Pai-88/cadence-fog-monitor/deliverables/cadence_leaflet_fog.pptx

UCL ENGF0031 · SMART CLOTHING PROTOTYPE

Cadence

A wearable that catches a Parkinson's gait freeze and shows it the instant it happens — on the body, on screen.

ONE SENSOR. THREE JOBS.

MONITOR

Tracks walking activity and movement energy continuously from one ankle accelerometer.

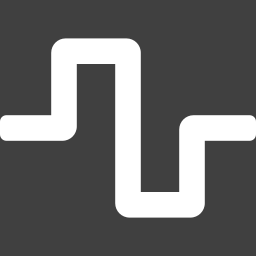
[picture p7: figure]

DETECT

Spots freezing of gait with a model trained and validated on real patient recordings.

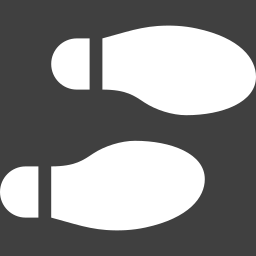
[picture p8: figure]

DISPLAY

Shows the live freeze state on an on-body OLED and logs every episode for the clinic.


HOW IT WORKS — FROM ANKLE TO SCREEN

Each freeze shows on-screen the instant it is detected, and is logged for review — one sensor in, one clear answer out.

SENSE
64 Hz · ankle

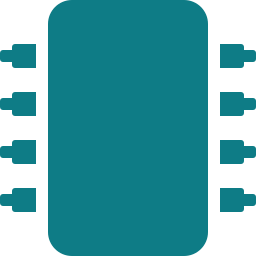
[picture p10: figure]

DETECT
freeze? (model)

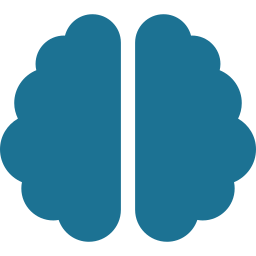
[picture p11: figure]

DISPLAY
OLED + log

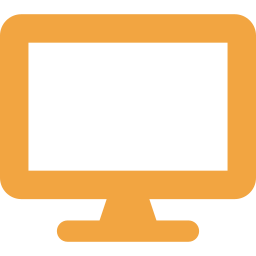
[picture p12: figure]
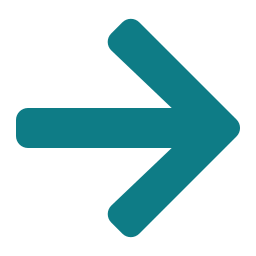
[picture p13: figure]

≈50%

of people with Parkinson's
experience freezing of gait*

64 Hz

single ankle
accelerometer

~2 s

freeze re-checked,
shown on the body

*Estimates vary with disease stage and assessment; commonly cited around 50%.

In good company. Builds on ideas demonstrated by Apple Watch's Movement Disorder API, PDMonitor and STAT-ON — clinical-grade Parkinson's monitors — in one low-cost wearable.

Validated on real patient recordings (Daphnet) using leave-one-subject-out testing.

Research prototype — not a medical device
UCL ENGF0031 Scenario 2 · 2026

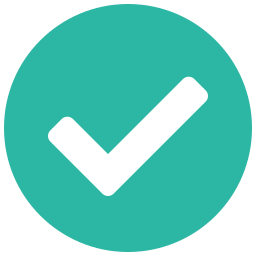
[picture p14: figure]

Cadence — wearable freeze-of-gait monitor
