Pai-88/cadence-fog-monitor/hardware/sleeve_layout.pdf

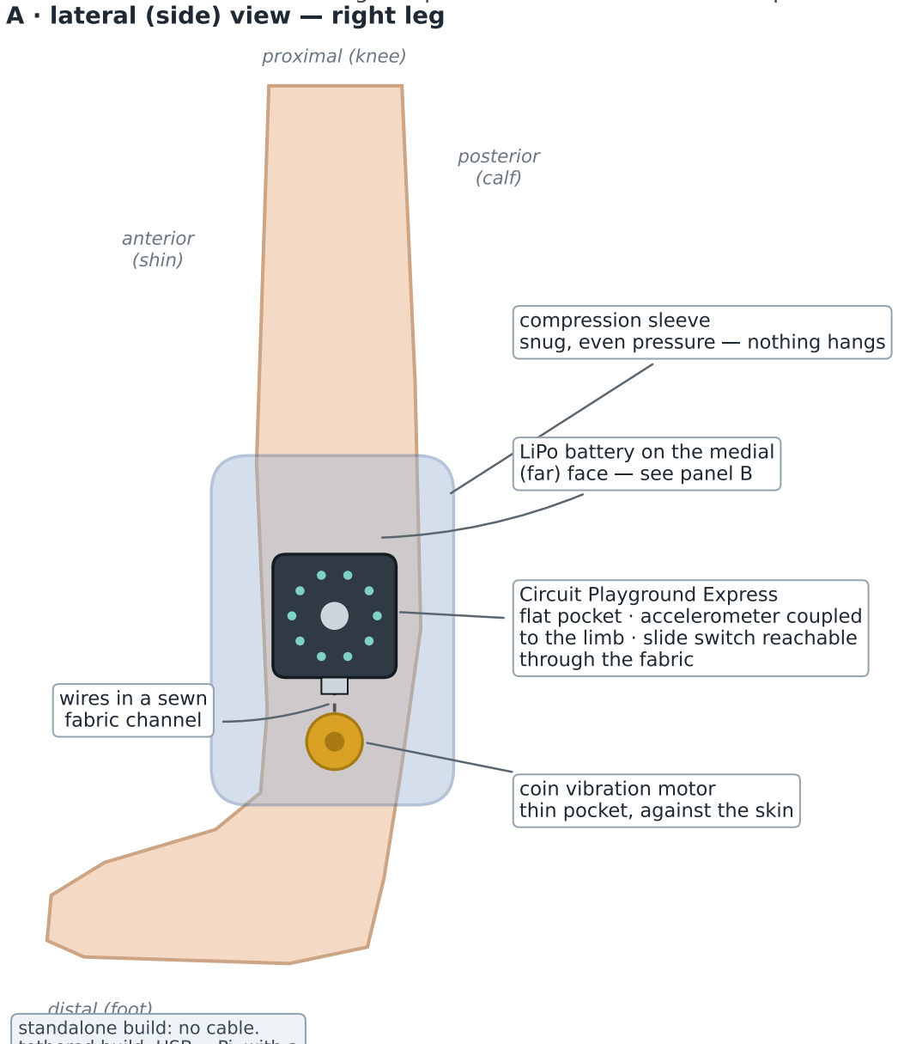
[picture p15: figure]
proximal (knee); distal (foot); anterior (shin); posterior (calf); standalone build: no cable.; A · lateral (side) view; right leg; compression sleeve snug, even pressure nothing hangs; LiPo battery on the medial (far) face see panel B; Circuit Playground Express flat pocket · accelerometer coupled to the limb · slide switch reachable through the fabric; coin vibration motor thin pocket, against the skin; wires in a sewn fabric channel

tethered build: USB Pi, with a strain-relief service loop.

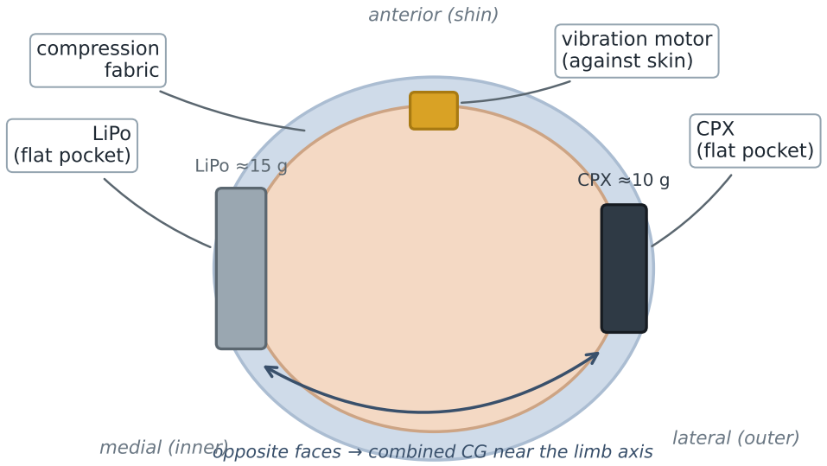
[picture p16: figure]
CPX 10 g; LiPo 15 g; anterior (shin); lateral (outer) medial (inner); CPX (flat pocket); LiPo (flat pocket); vibration motor (against skin) compression fabric

opposite faces combined CG near the limb axis

posterior (calf)

B · cross-section (looking toward the foot)

limb /
skin

inner fabric

component
(CPX / LiPo)

outer fabric
(closes pocket)

toward limb outside

3 4 mm sits flush, nothing to snag

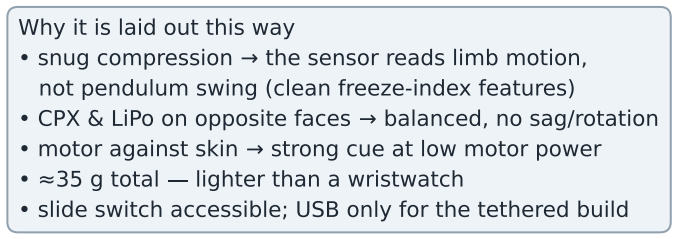
[picture p17: figure]
Why it is laid out this way; 35 g total lighter than a wristwatch

snug compression the sensor reads limb motion,
not pendulum swing (clean freeze-index features)
CPX & LiPo on opposite faces balanced, no sag/rotation motor against skin strong cue at low motor power

slide switch accessible; USB only for the tethered build

C · flat-pocket layer stack (radial section)

Parkinson's gait garment ankle-sleeve component layout snug compression sleeve · flat internal pockets · nothing hangs · 35 g total (CPX 10 g + LiPo 15 g + motor 2 g)
