Pai-88/cadence-fog-monitor/worksheet/demo_how_it_decides.pdf

# How the wrist band decides: REST · MOVE · TREMOR

No maths needed to run the demo — the band just checks two things every 2 seconds, then lights up one of three states.

Do this first (set-up): Hold your wrist still and press button A. The band learns your normal resting hand, so the “line” it compares against is personal to you. (Until you do, the ring glows dim white = “not calibrated yet”.)

Every 2 seconds, it measures two things about your wrist:

### 1. Arm movement

Big, slow motion — reaching, waving, walking. “Are you using your hand on purpose?”

### 2. Tremor shake

A fast, fine, rhythmic shake while the hand is otherwise still — the Parkinson’s resting tremor.

Then it picks one of three — checked in this order:

### 1 MOVE

Arm is moving about.
You’re doing something on purpose. A resting tremor only shows at rest, so the band stays quiet — no false alarms on normal activity.

You’ll see: dim teal ring · screen says moving

### 2 TREMOR

Still, but shaking past your line.
Hand at rest and trembling more than your calibrated normal — so it flags a tremor. Stronger shake → more lights fill the ring.

You’ll see: amber bar (length = strength) · screen says TREMOR present

### 3 REST

Still and calm.
No big movement, no tremor shake — nothing going on. All clear. The default whenever the other two aren’t true.

You’ll see: soft green ring · screen says no tremor

Show it in three moves: 1. Hold still → REST (green). 2. Wave your hand around → MOVE (teal). 3. Rest your hand and shake it fast → TREMOR (amber).

If someone asks “how does it know?” — the one-line answer: “It measures how strongly the hand shakes at a tremor’s rhythm, and whether you’re otherwise still.” (Under the hood that’s the strength of 4–6 Hz shaking, and it waits for two readings in a row before switching — but you don’t need to say any of that to run the demo.)

1
