Pai-88/cadence-fog-monitor/colab/fog_plots/interp_partial_dependence.png

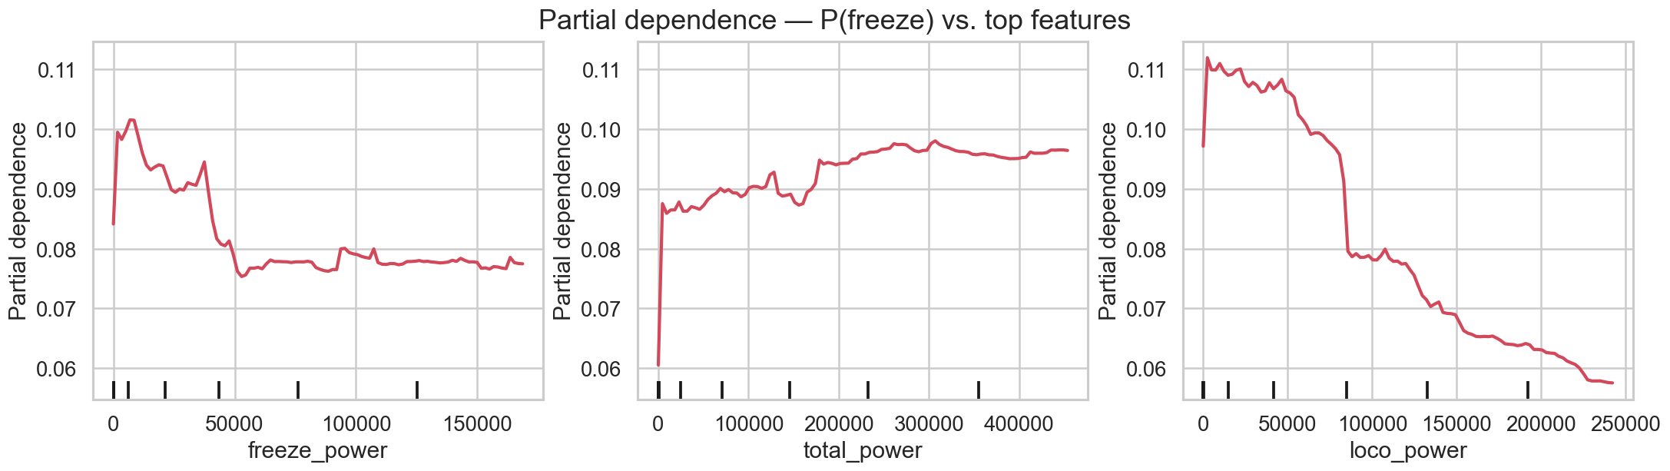
colab/fog_plots/interp_partial_dependence.png
