Pai-88/cadence-fog-monitor/colab/fog_plots/interp_perm_importance.png

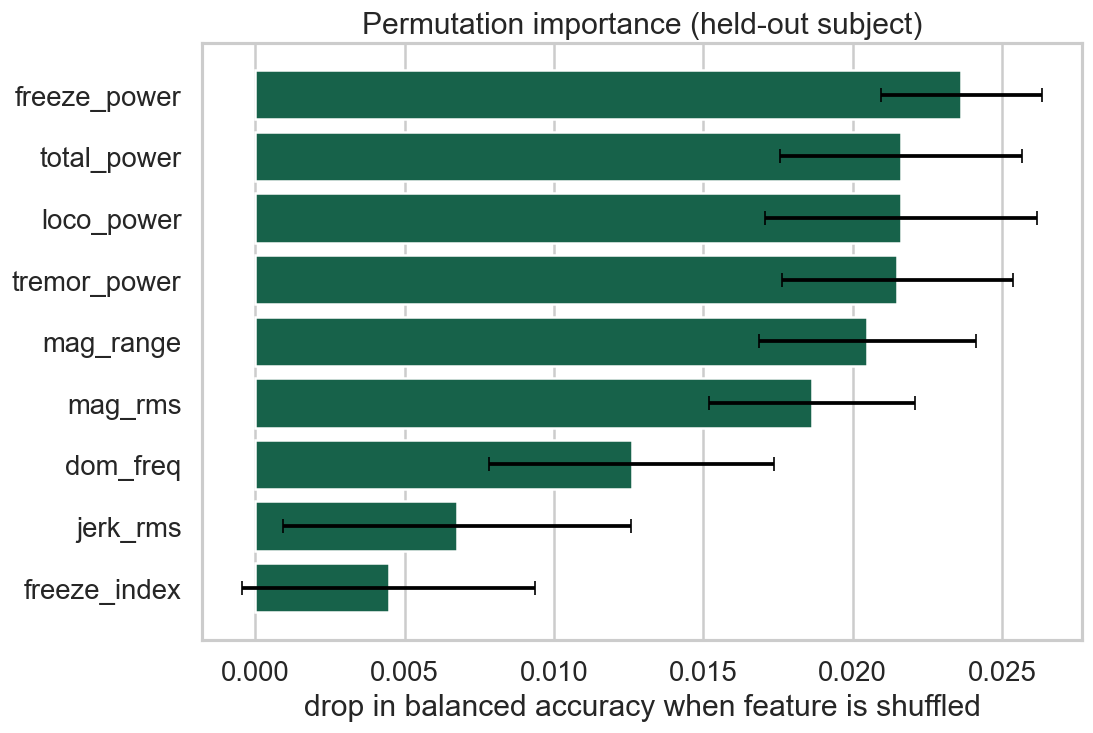
colab/fog_plots/interp_perm_importance.png
