Pai-88/cadence-fog-monitor/colab/fog_plots/interp_shap_bar.png

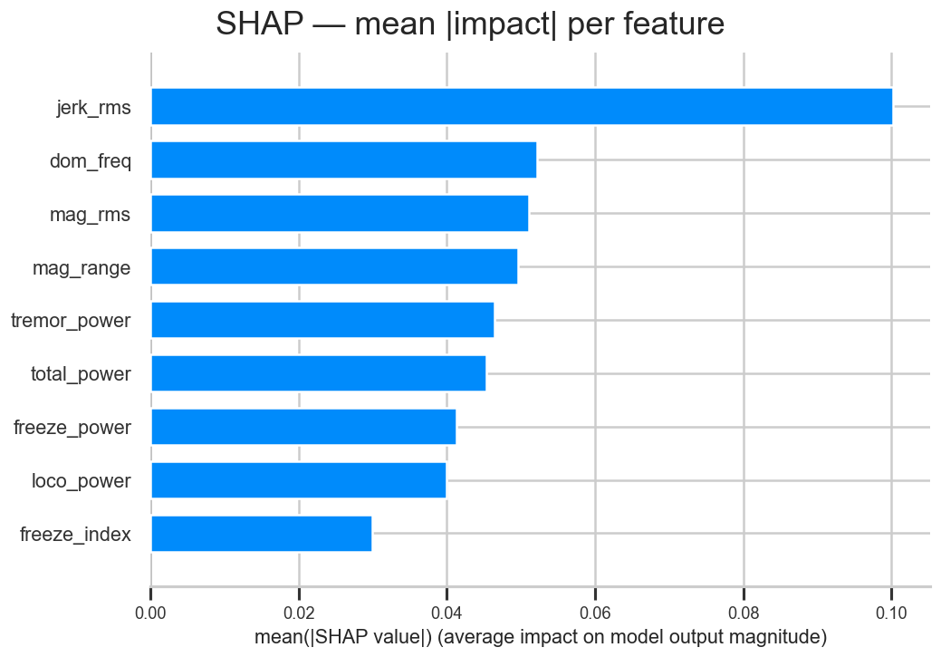
colab/fog_plots/interp_shap_bar.png
