Pai-88/cadence-fog-monitor/colab/fog_plots/interp_shap_beeswarm.png

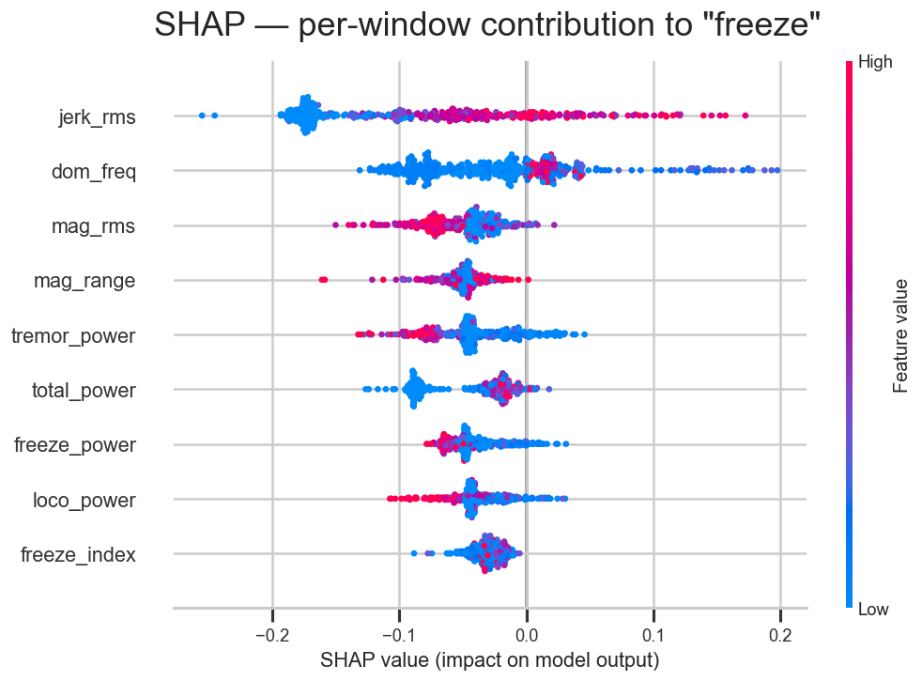
colab/fog_plots/interp_shap_beeswarm.png
