Pai-88/cadence-fog-monitor/deliverables/fogqa2-1.jpg

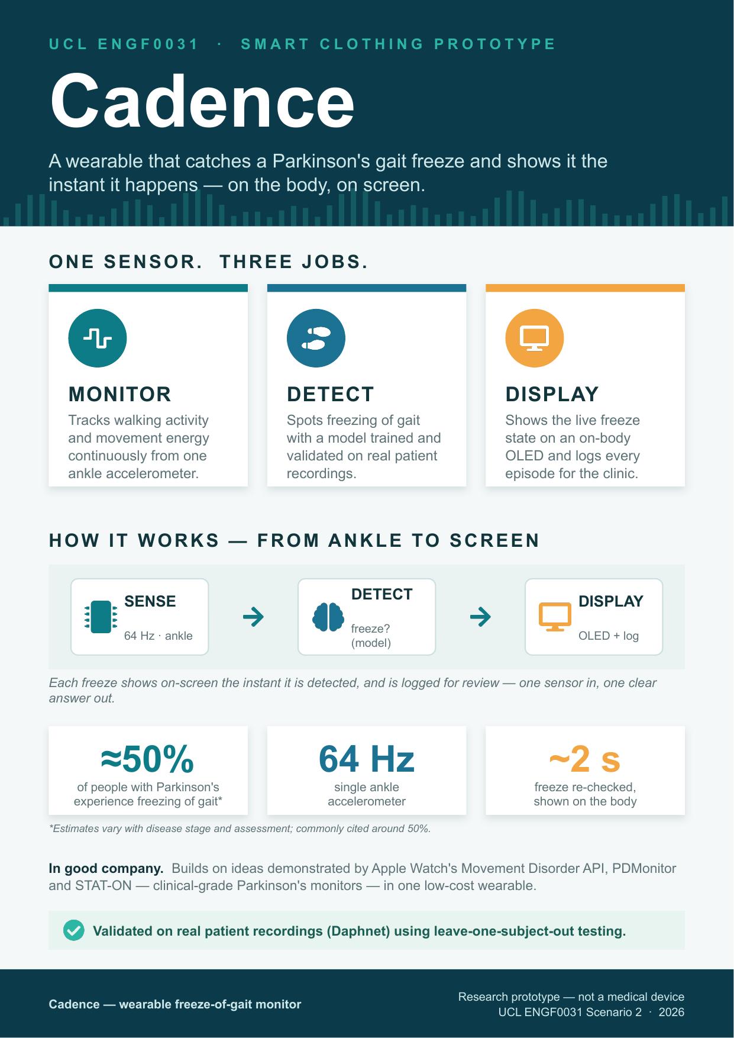
deliverables/fogqa2-1.jpg
