Pai-88/cadence-fog-monitor/hardware/coding_flowchart.png

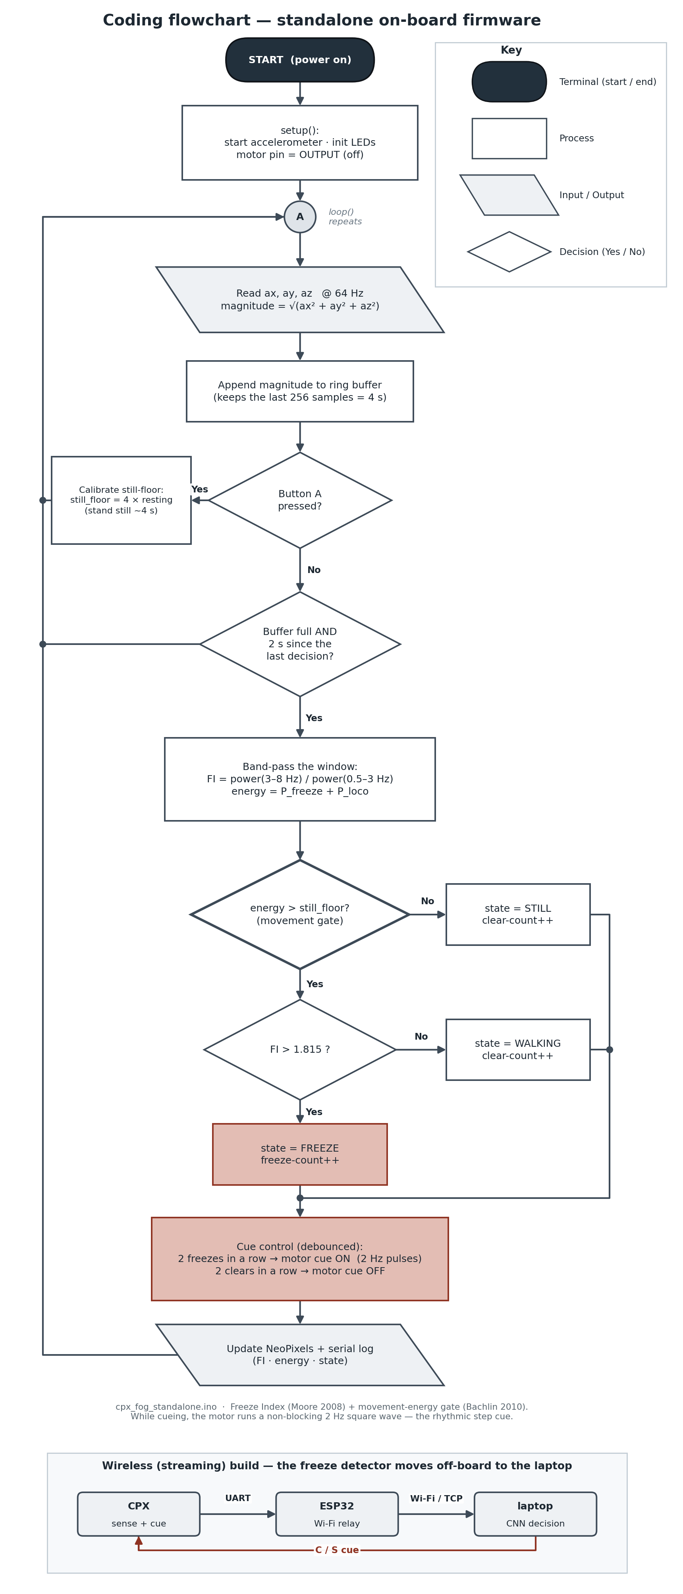
hardware/coding_flowchart.png
