Pai-88/cadence-fog-monitor/hardware/sleeve_layout.png

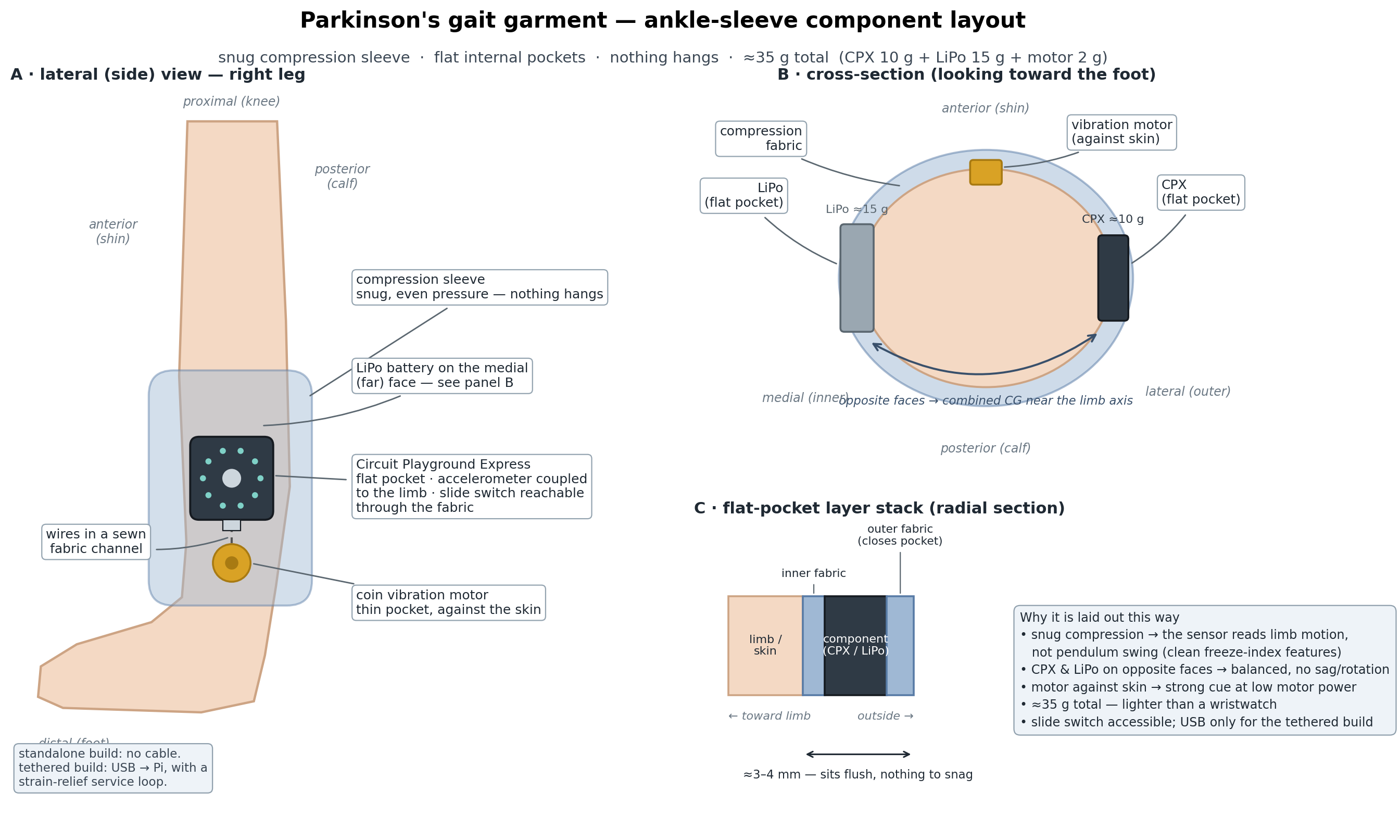
hardware/sleeve_layout.png
