Pai-88/cadence-fog-monitor/hardware/wp1_right.png

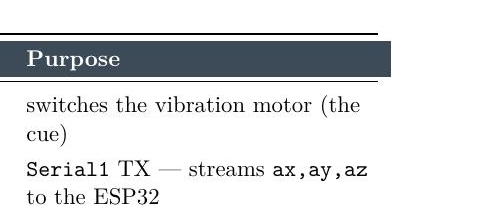
hardware/wp1_right.png
