Pai-88/cadence-fog-monitor/hardware/wp2_right2.png

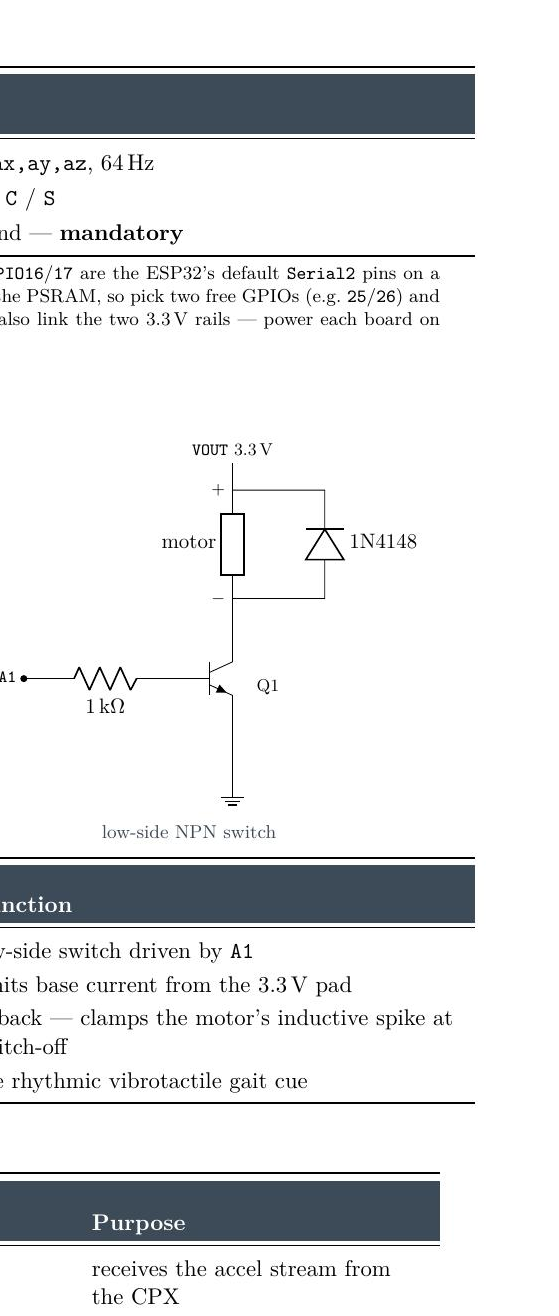
hardware/wp2_right2.png
