Pai-88/cadence-fog-monitor/hardware/wp2_right.png

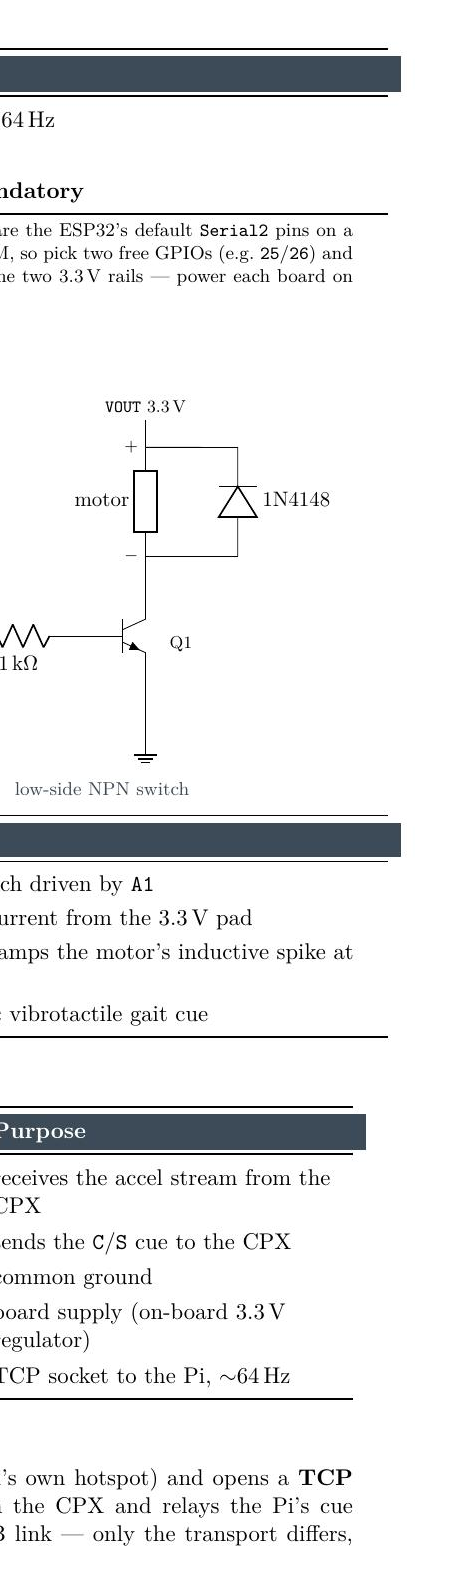
hardware/wp2_right.png
