Pai-88/cadence-fog-monitor/hardware/wp3_host.png

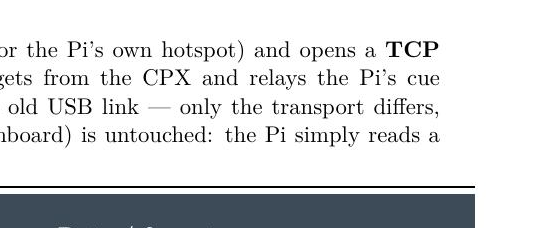
hardware/wp3_host.png
