Pai-88/cadence-fog-monitor/hardware/wp3_right.png

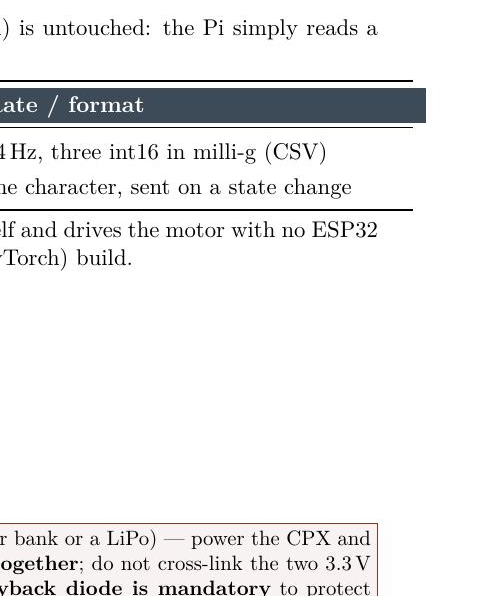
hardware/wp3_right.png
