Pai-88/cadence-fog-monitor/hardware/wp-1.jpg

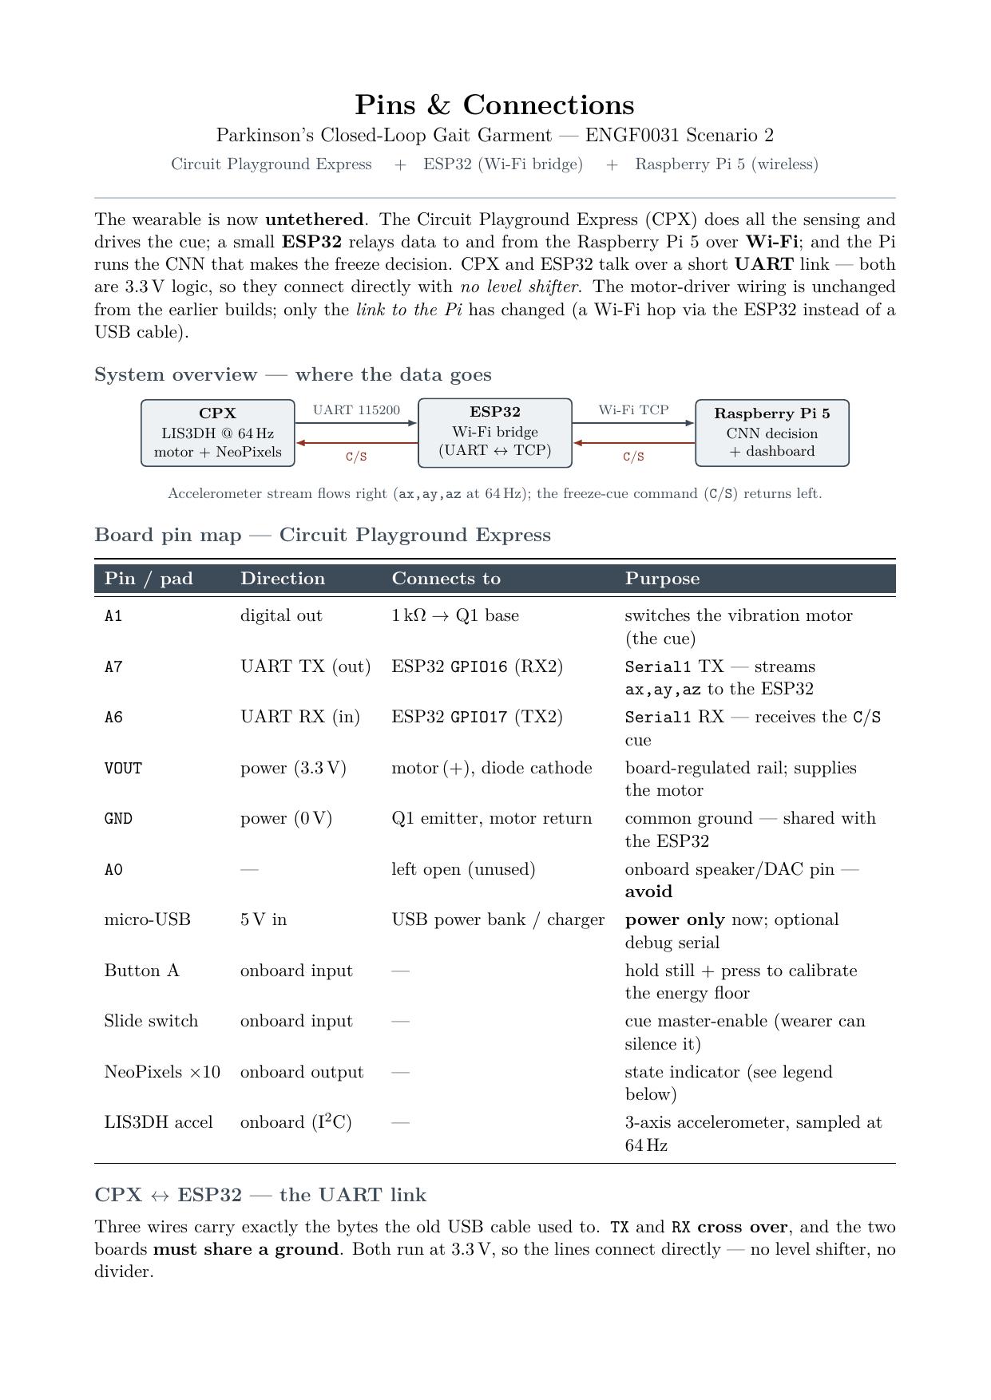
hardware/wp-1.jpg
