Pai-88/cadence-fog-monitor/hardware/wp-2.jpg

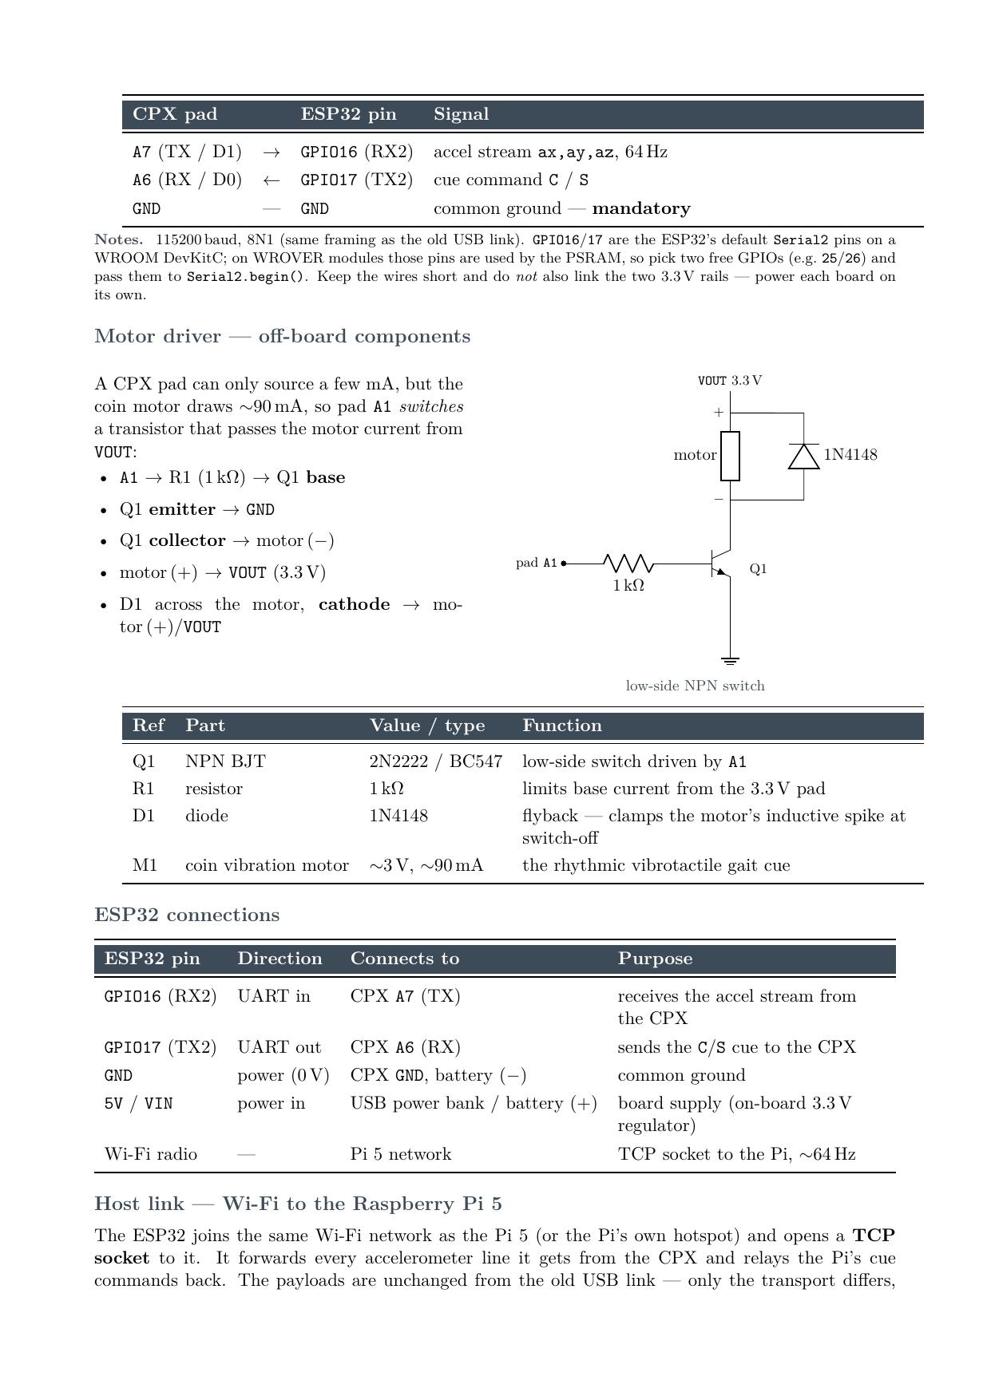
hardware/wp-2.jpg
