Pai-88/cadence-fog-monitor/hardware/wp-3.jpg

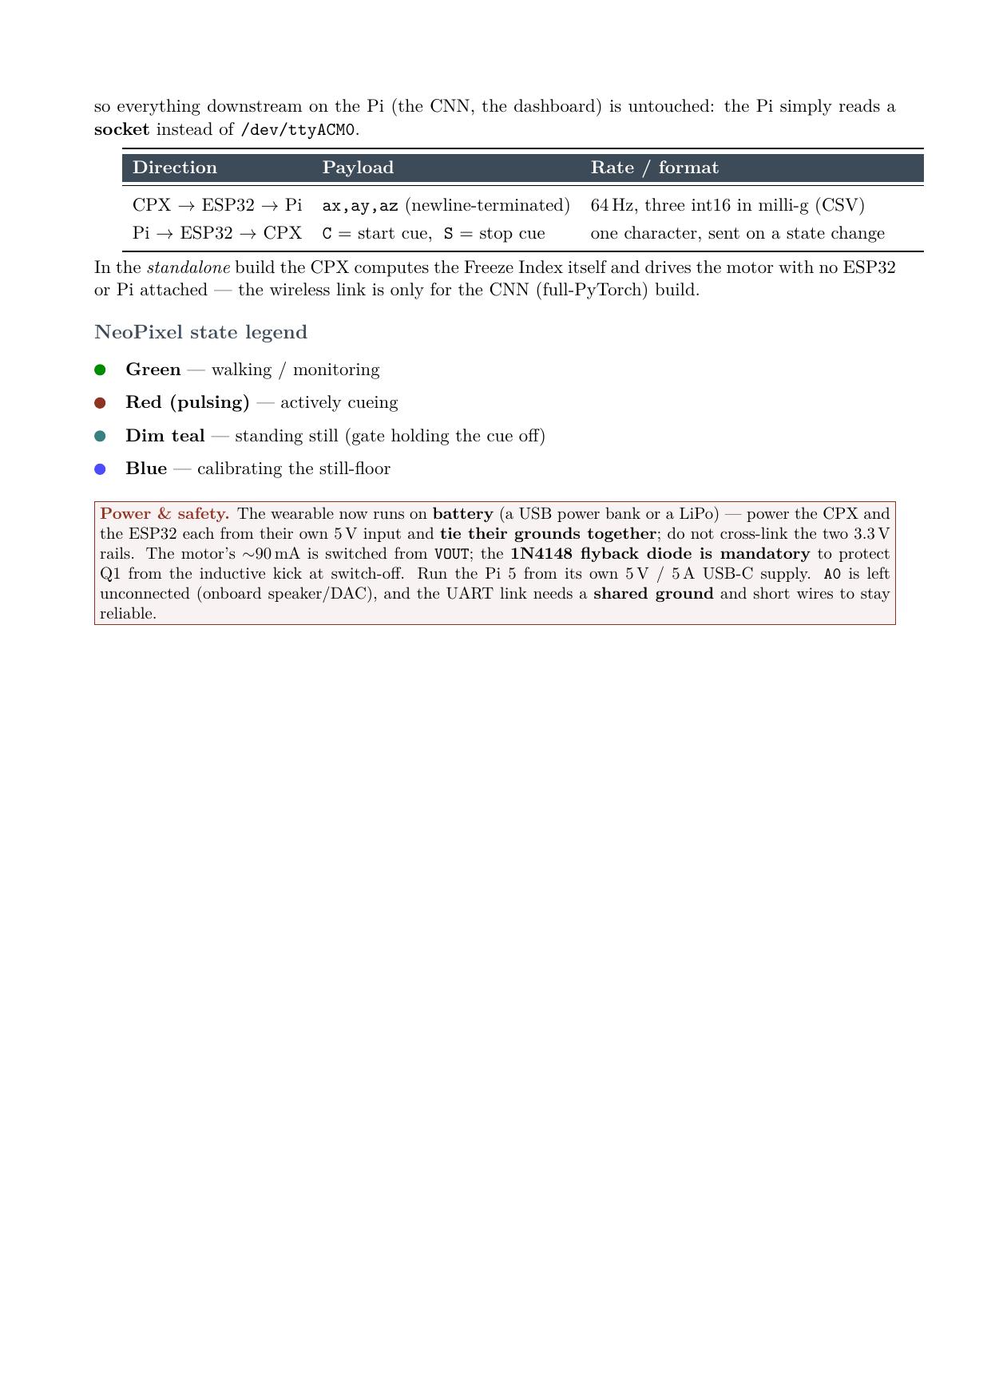
hardware/wp-3.jpg
