Pai-88/cadence-fog-monitor/pi/accuracy_figs/accuracy_caveat.png

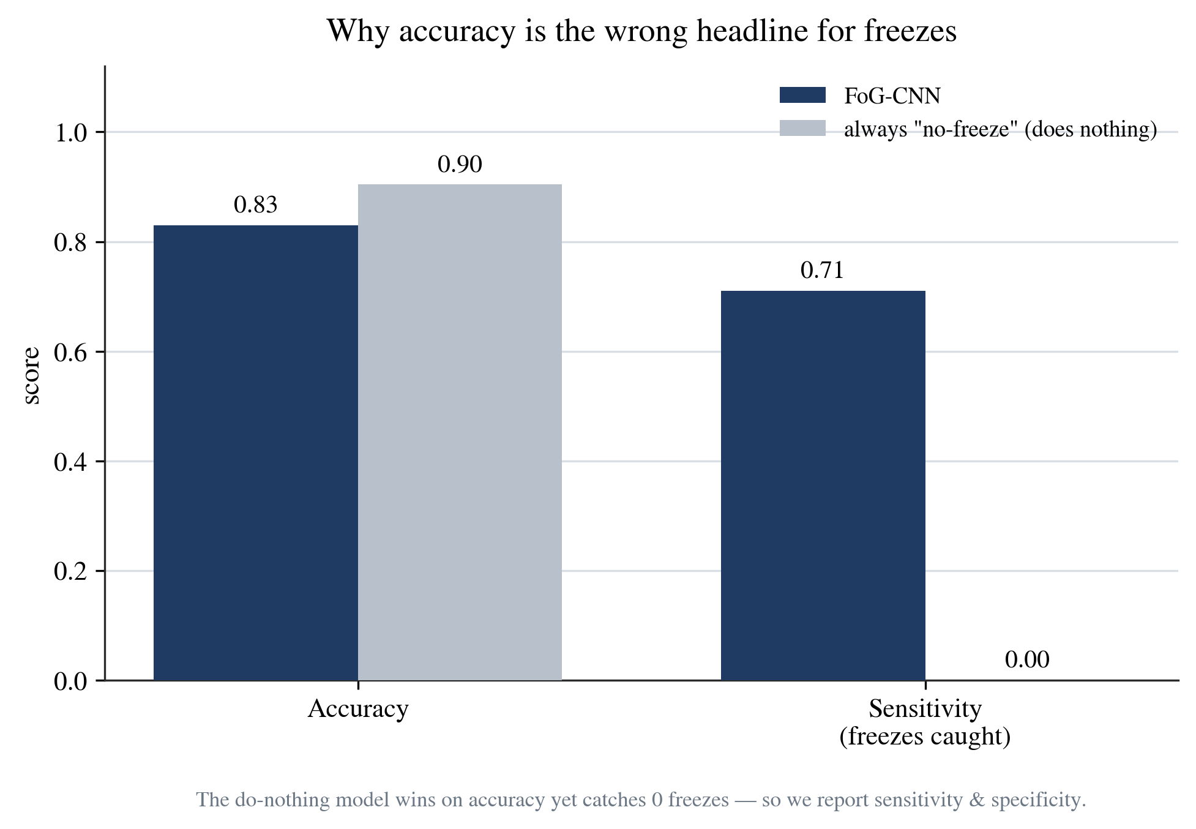
pi/accuracy_figs/accuracy_caveat.png
