Pai-88/cadence-fog-monitor/pi/accuracy_figs/bce_loss.png

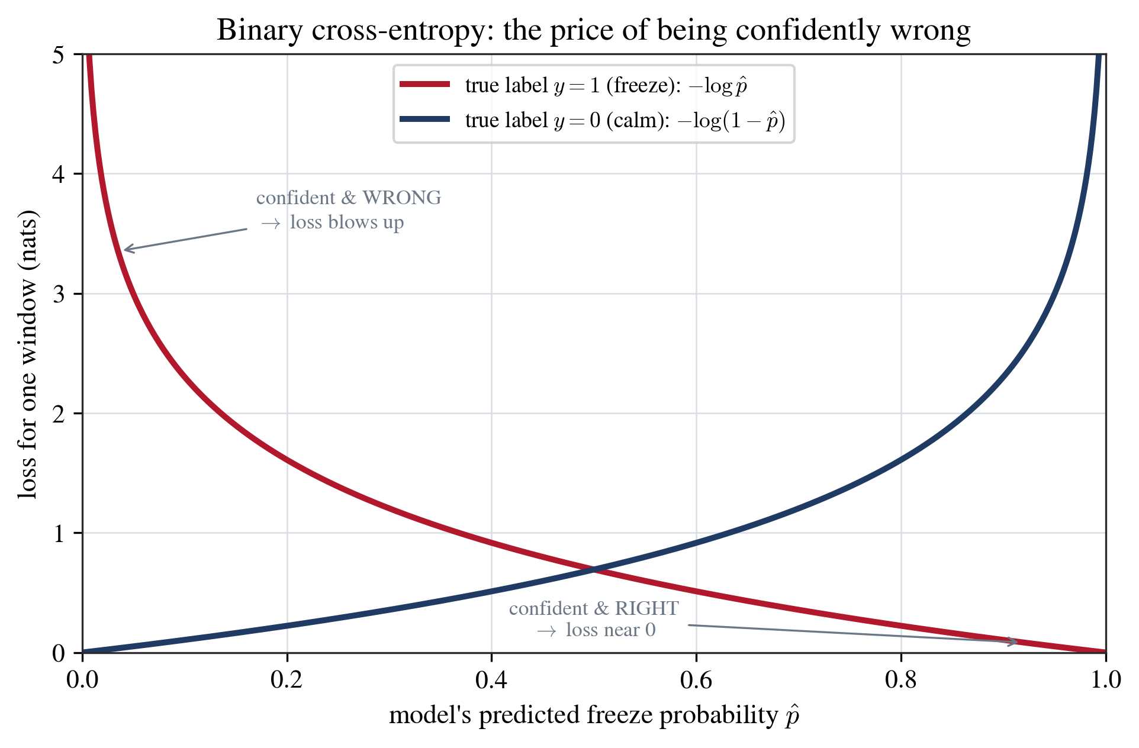
pi/accuracy_figs/bce_loss.png
