Pai-88/cadence-fog-monitor/pi/accuracy_figs/confusion_matrix.png

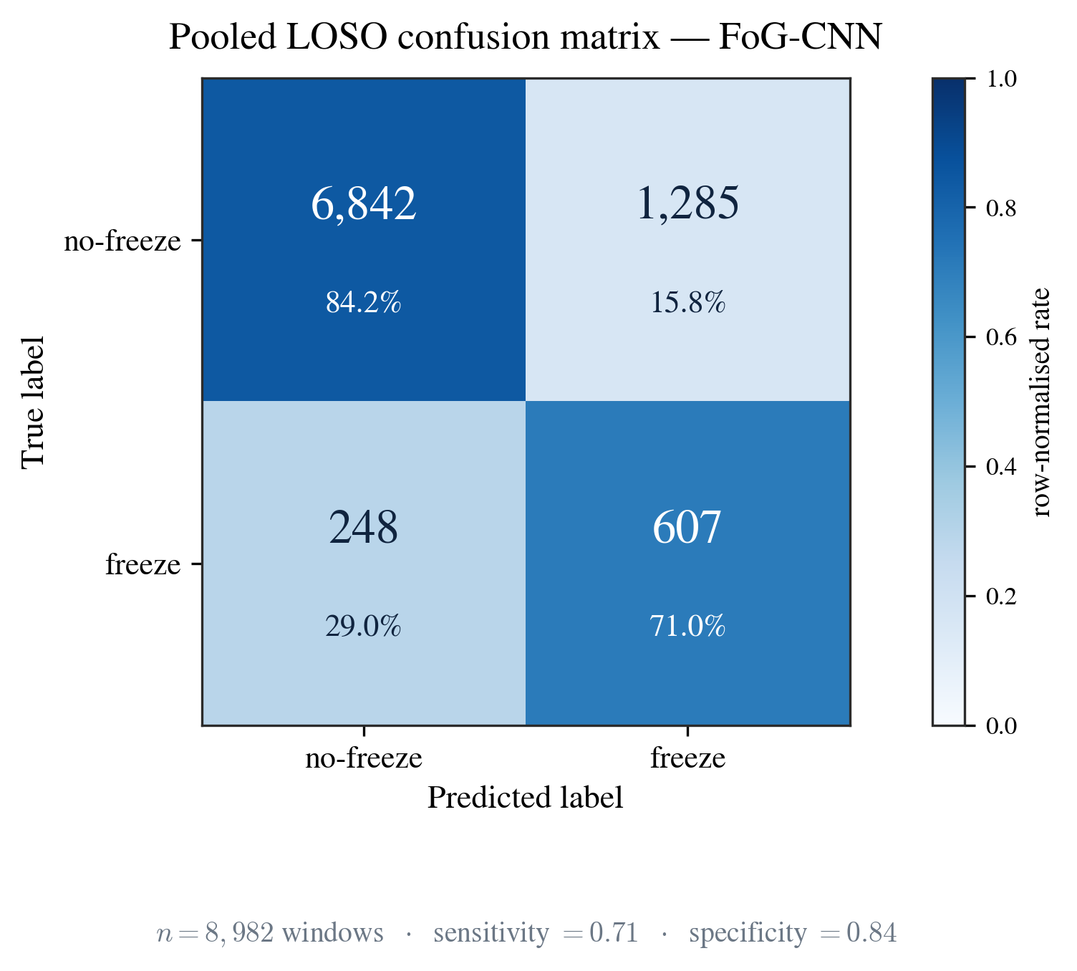
pi/accuracy_figs/confusion_matrix.png
