Pai-88/cadence-fog-monitor/pi/accuracy_figs/decision_contour.png

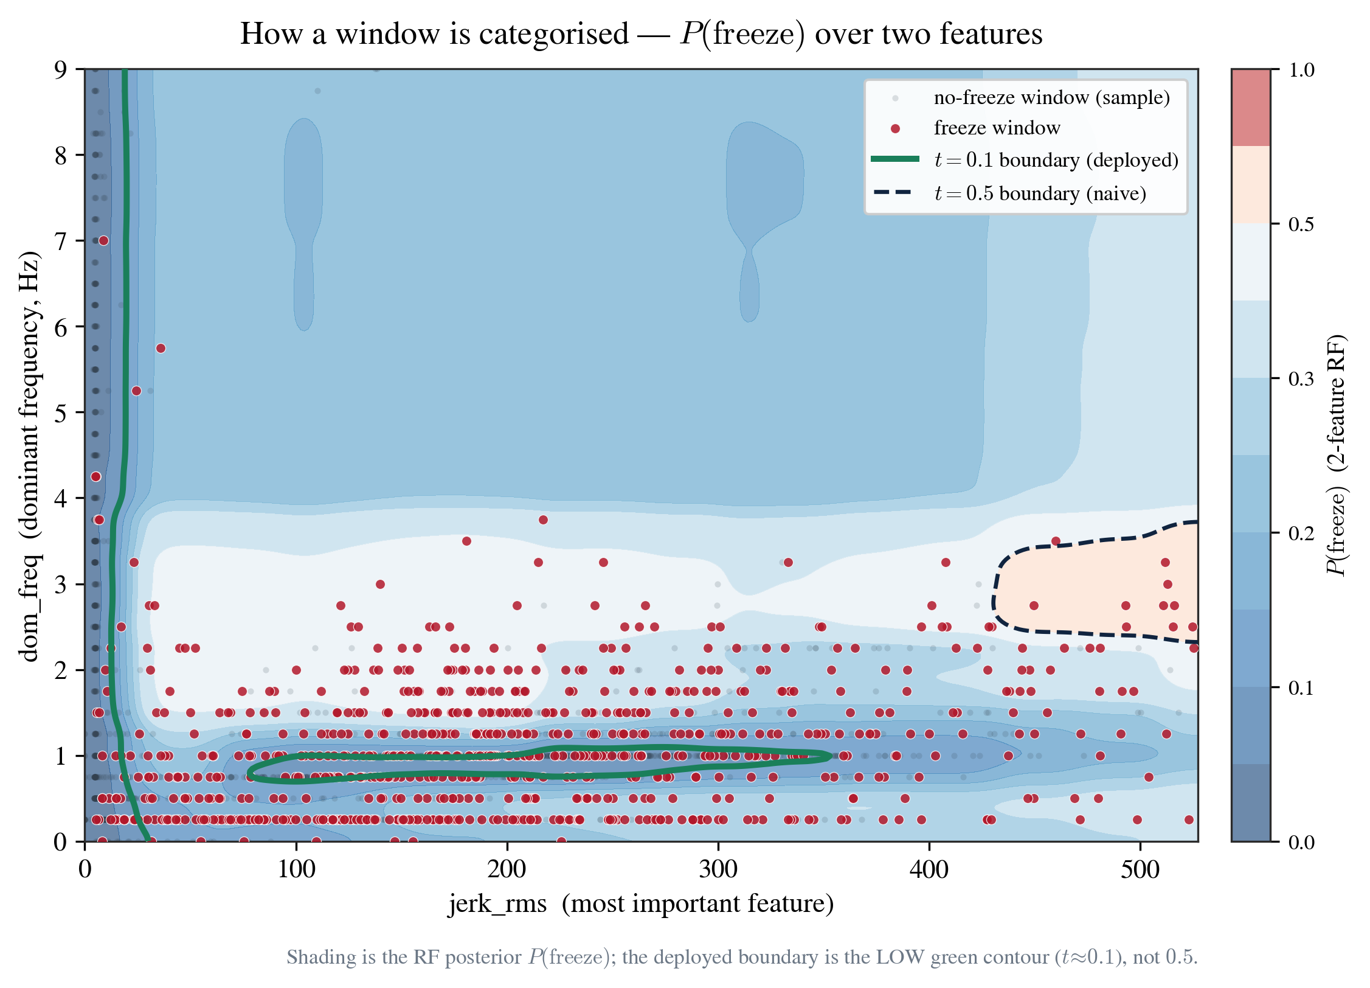
pi/accuracy_figs/decision_contour.png
