Pai-88/cadence-fog-monitor/pi/accuracy_figs/feature_corr.png

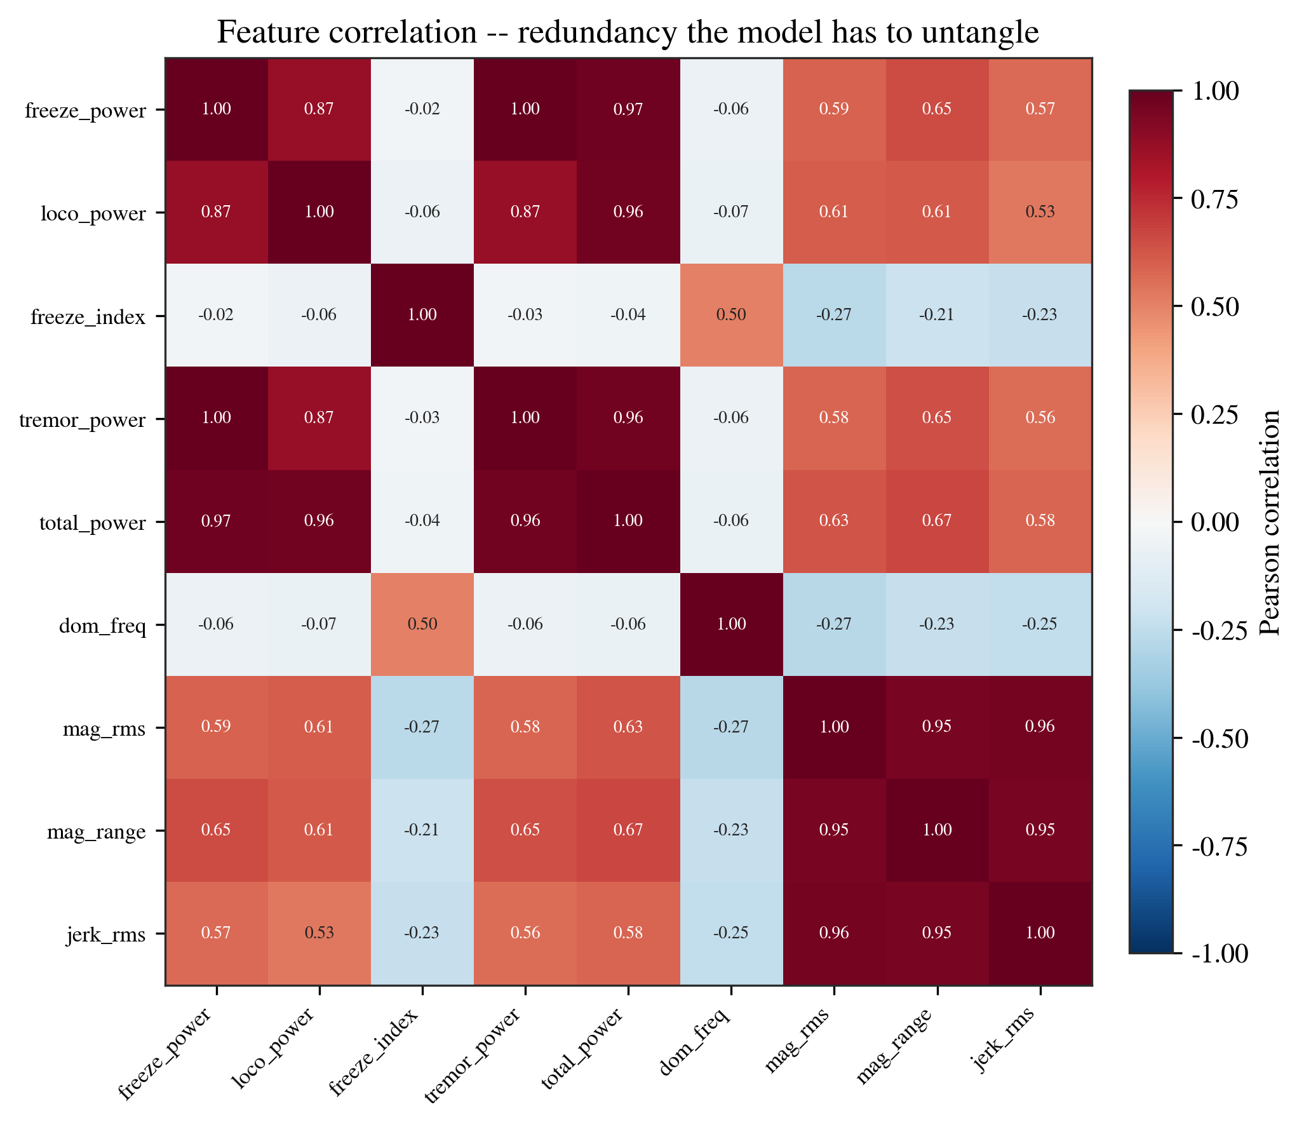
pi/accuracy_figs/feature_corr.png
