Pai-88/cadence-fog-monitor/pi/accuracy_figs/feature_dist.png

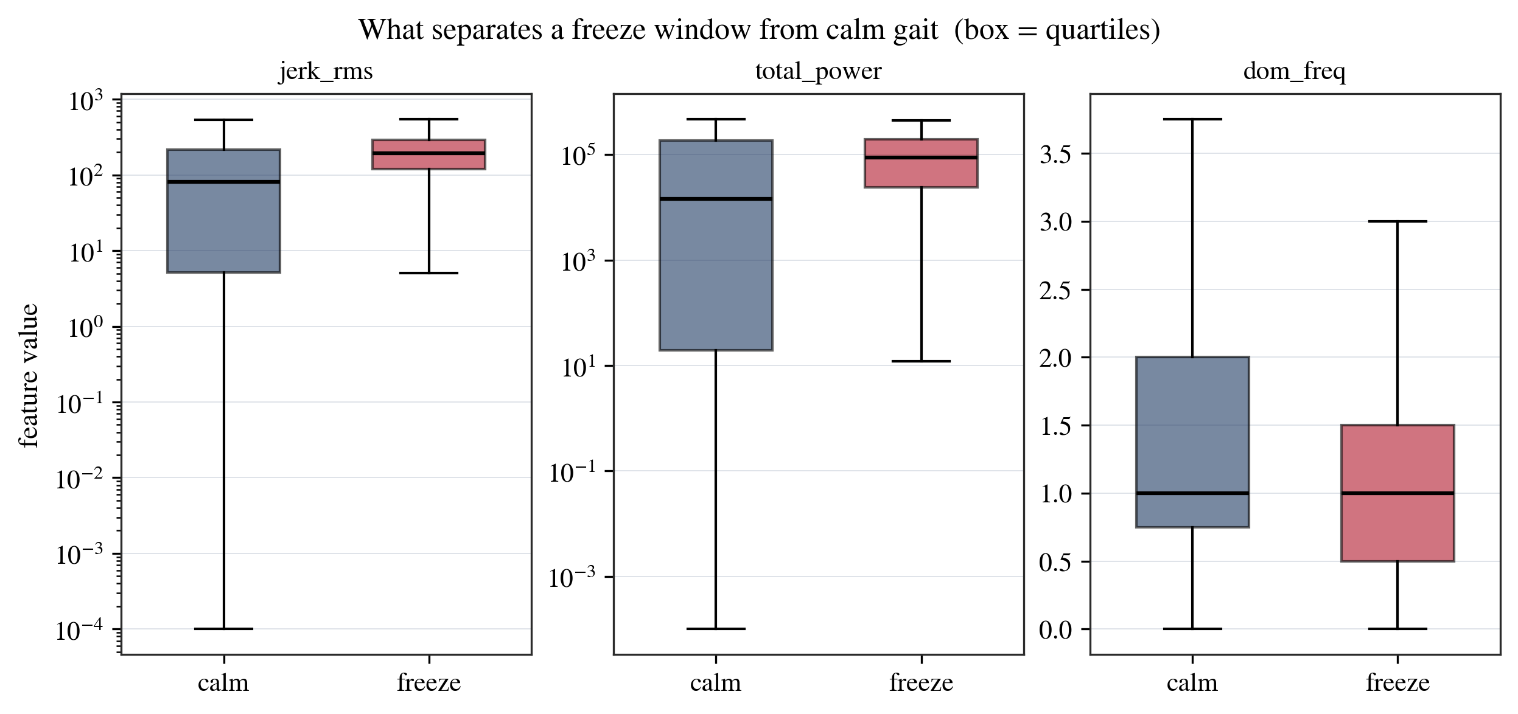
pi/accuracy_figs/feature_dist.png
