Pai-88/cadence-fog-monitor/pi/accuracy_figs/param_grid.png

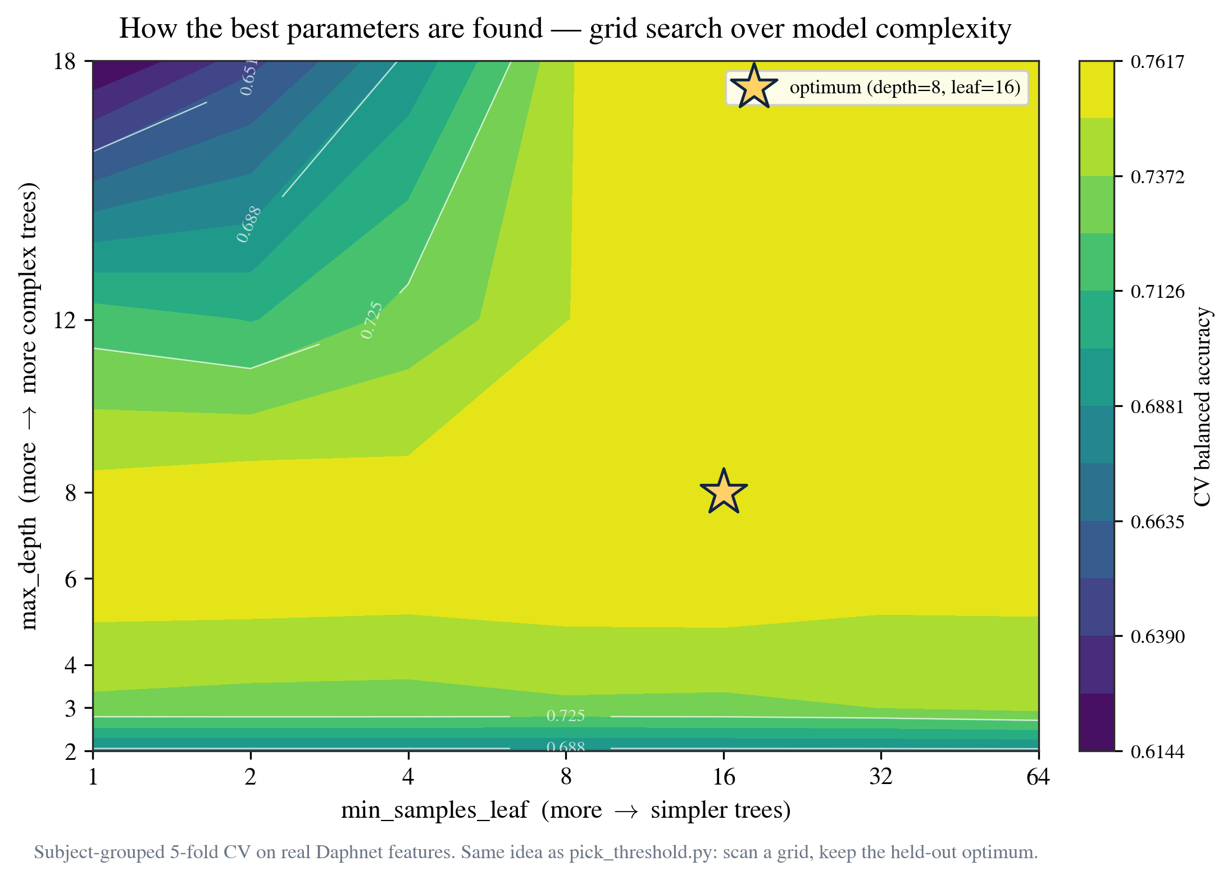
pi/accuracy_figs/param_grid.png
