Pai-88/cadence-fog-monitor/pi/accuracy_figs/per_subject.png

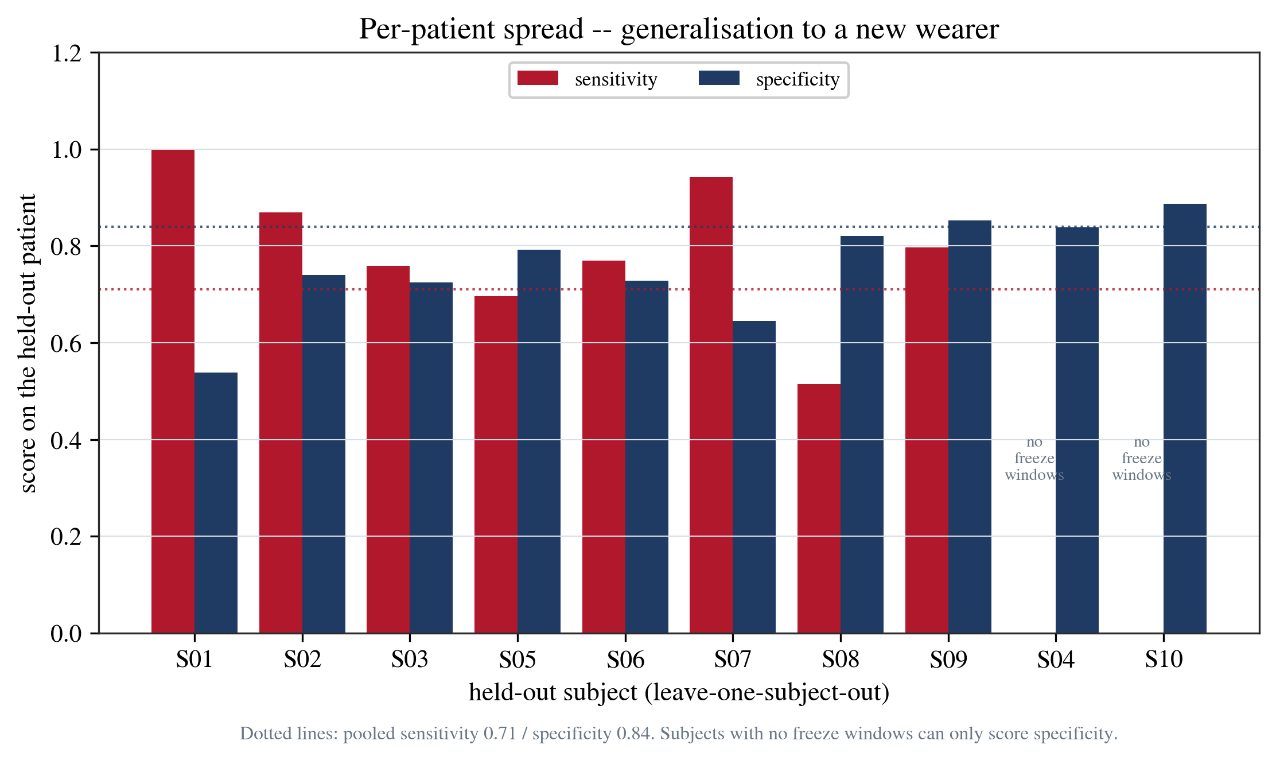
pi/accuracy_figs/per_subject.png
