Pai-88/cadence-fog-monitor/pi/accuracy_figs/pr_curve.png

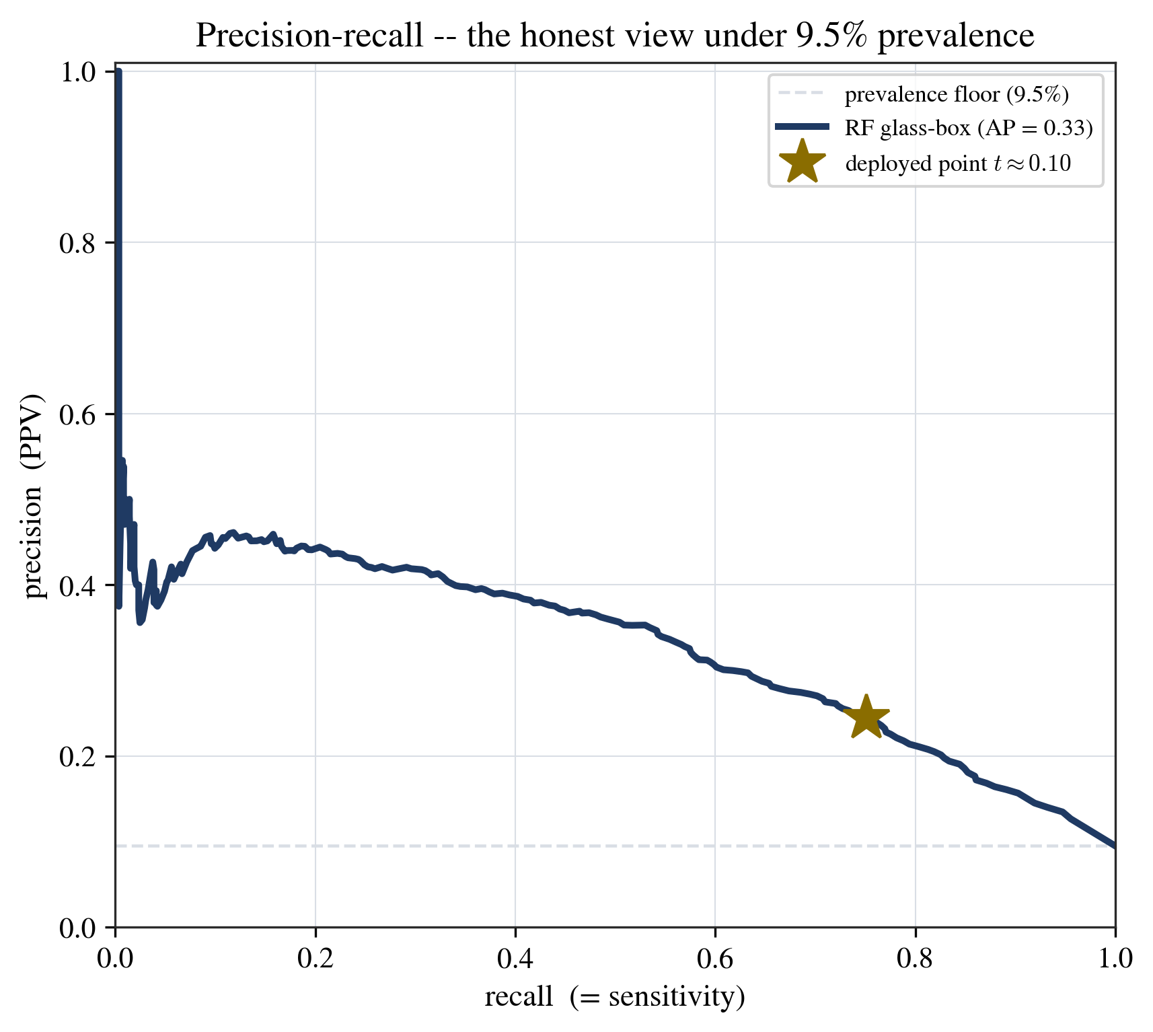
pi/accuracy_figs/pr_curve.png
