Pai-88/cadence-fog-monitor/pi/accuracy_figs/roc_curve.png

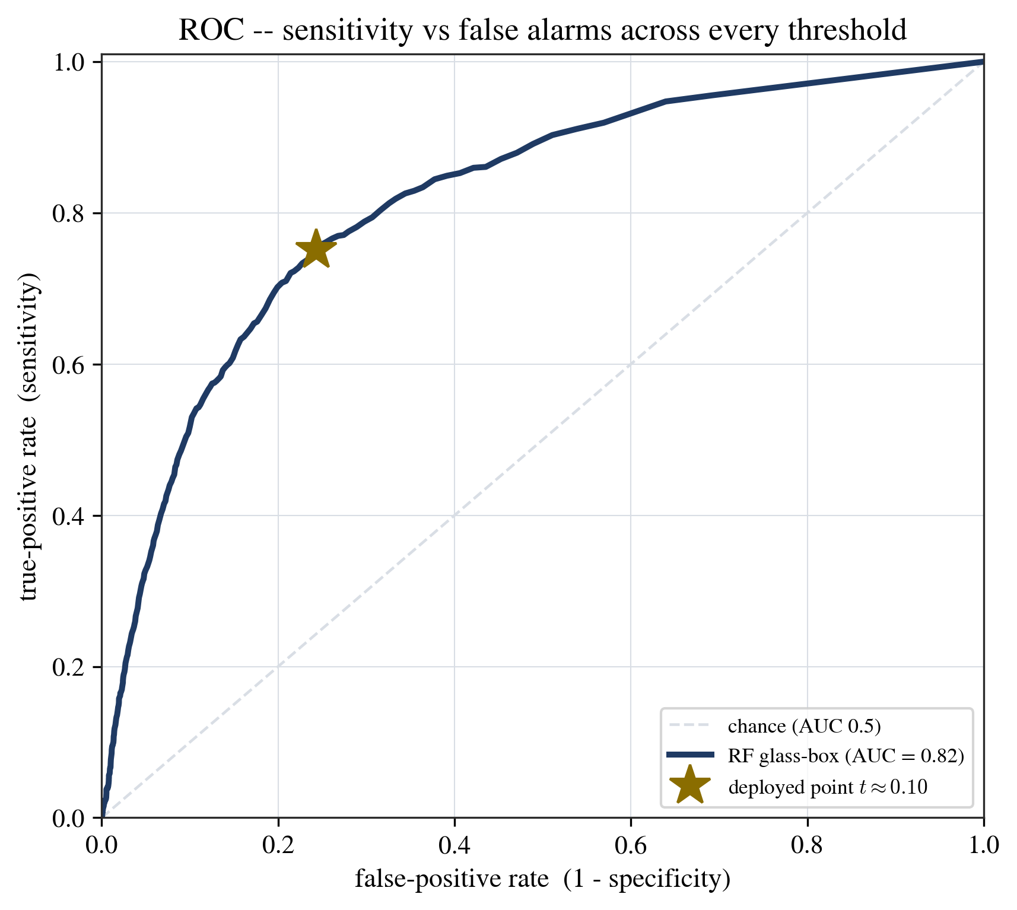
pi/accuracy_figs/roc_curve.png
