Pai-88/cadence-fog-monitor/pi/accuracy_figs/score_hist.png

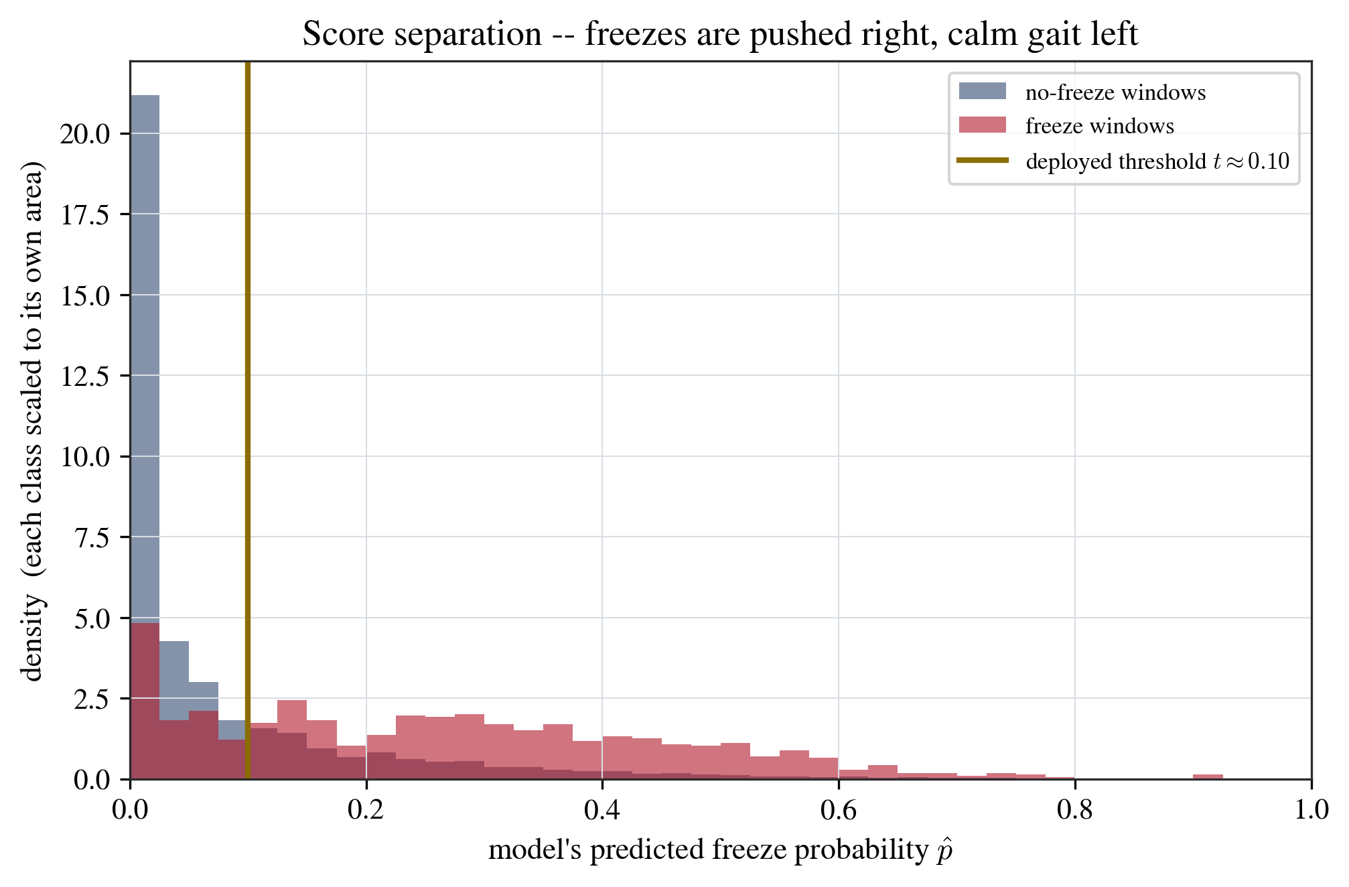
pi/accuracy_figs/score_hist.png
