Pai-88/cadence-fog-monitor/pi/accuracy_figs/shap_bar.png

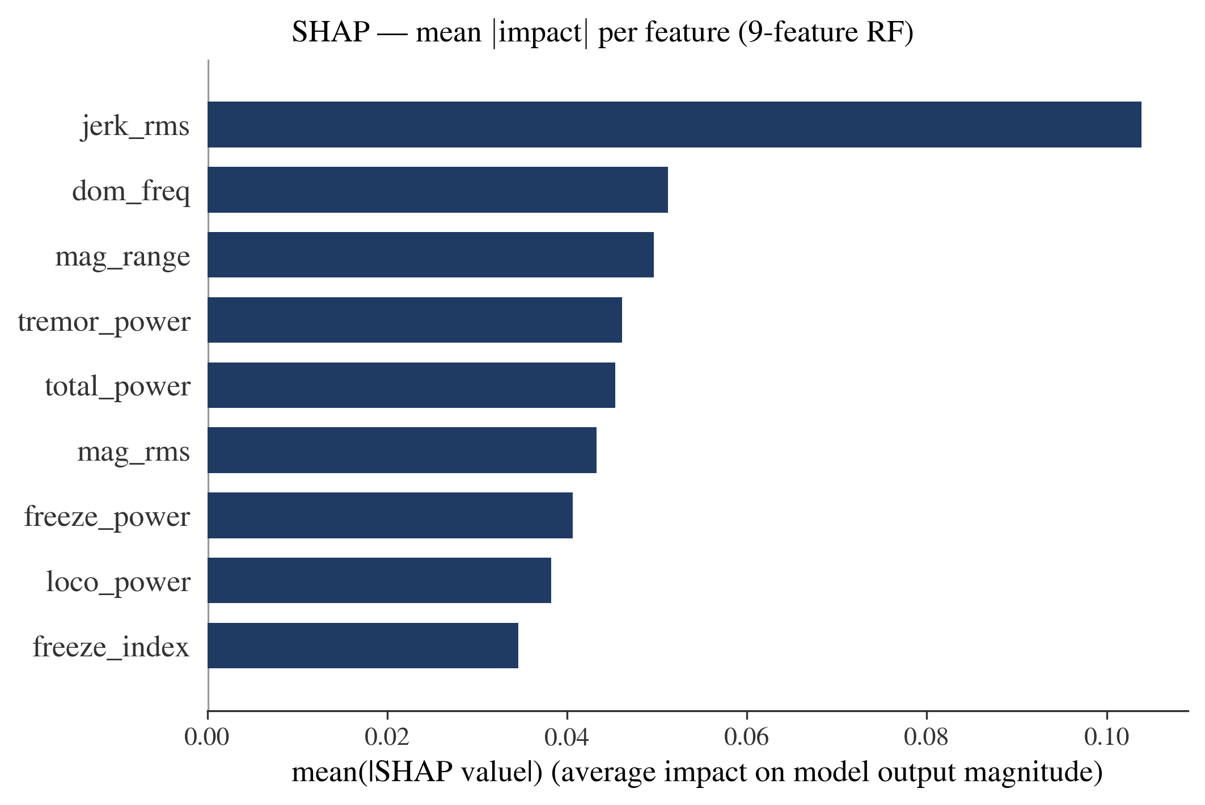
pi/accuracy_figs/shap_bar.png
