Pai-88/cadence-fog-monitor/pi/accuracy_figs/shap_beeswarm.png

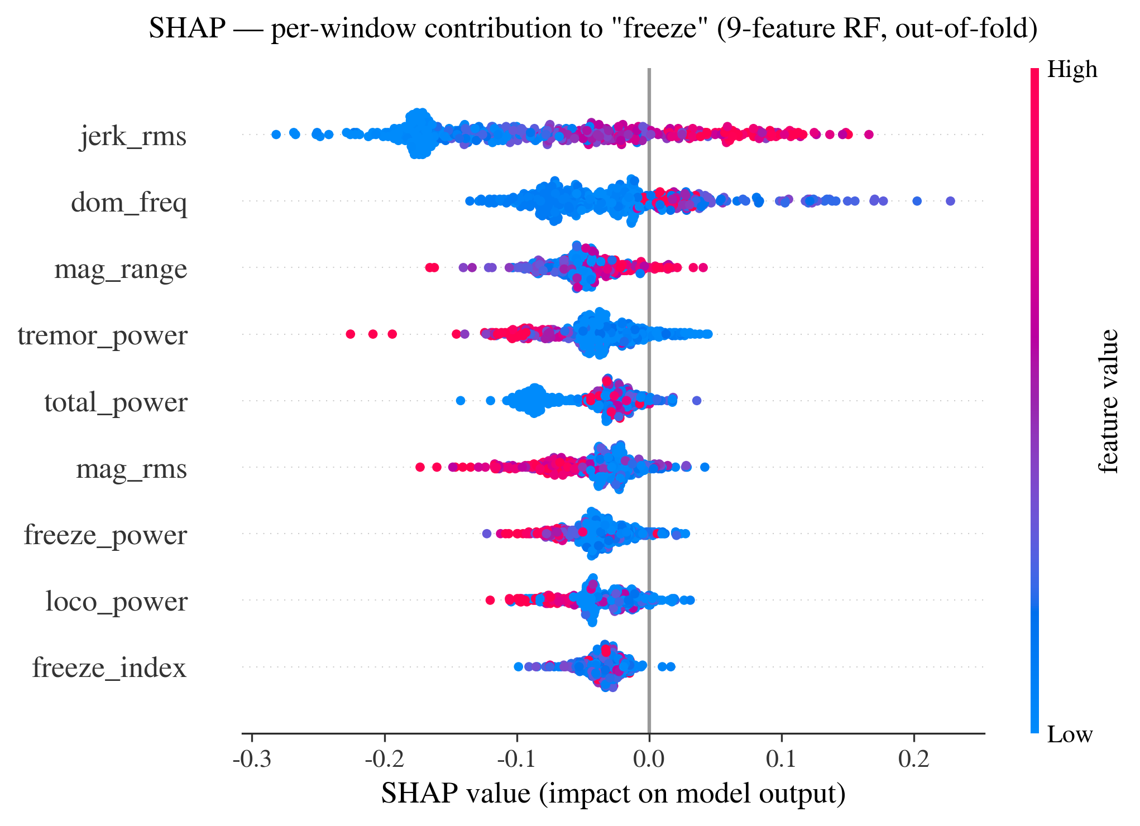
pi/accuracy_figs/shap_beeswarm.png
