Pai-88/cadence-fog-monitor/pi/accuracy_figs/sigmoid.png

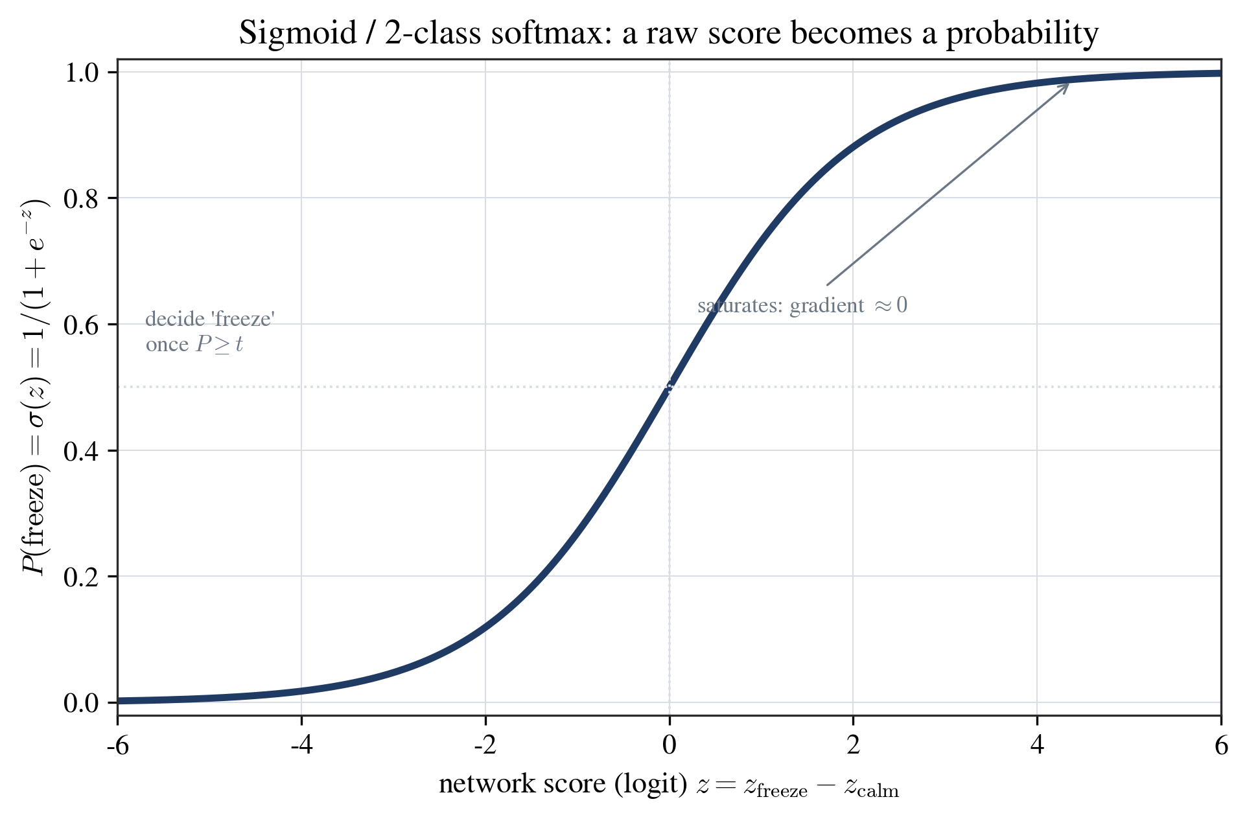
pi/accuracy_figs/sigmoid.png
