Pai-88/cadence-fog-monitor/pi/accuracy_figs/smoketest_out/smoketest_trace.png

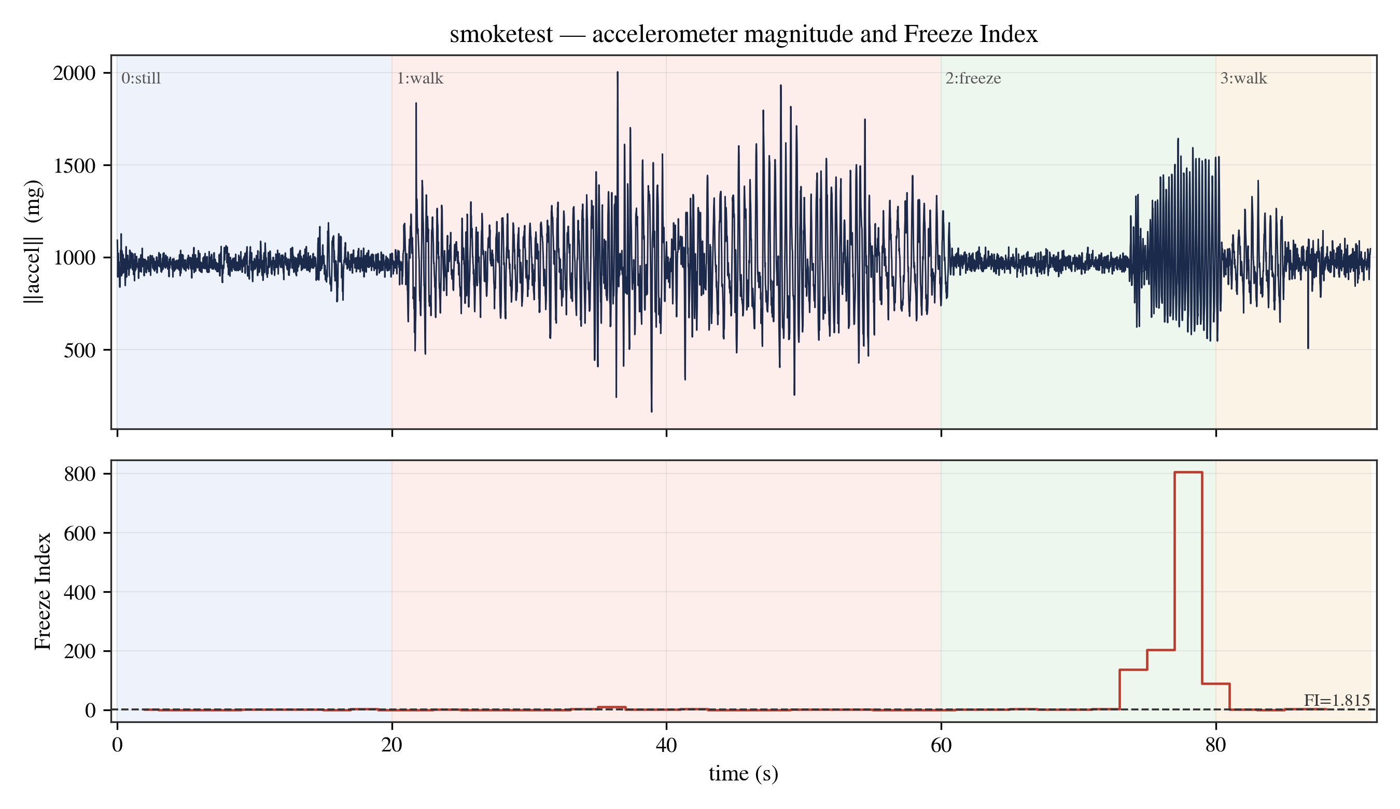
pi/accuracy_figs/smoketest_out/smoketest_trace.png
