Pai-88/cadence-fog-monitor/pi/accuracy_figs/train_curve.png

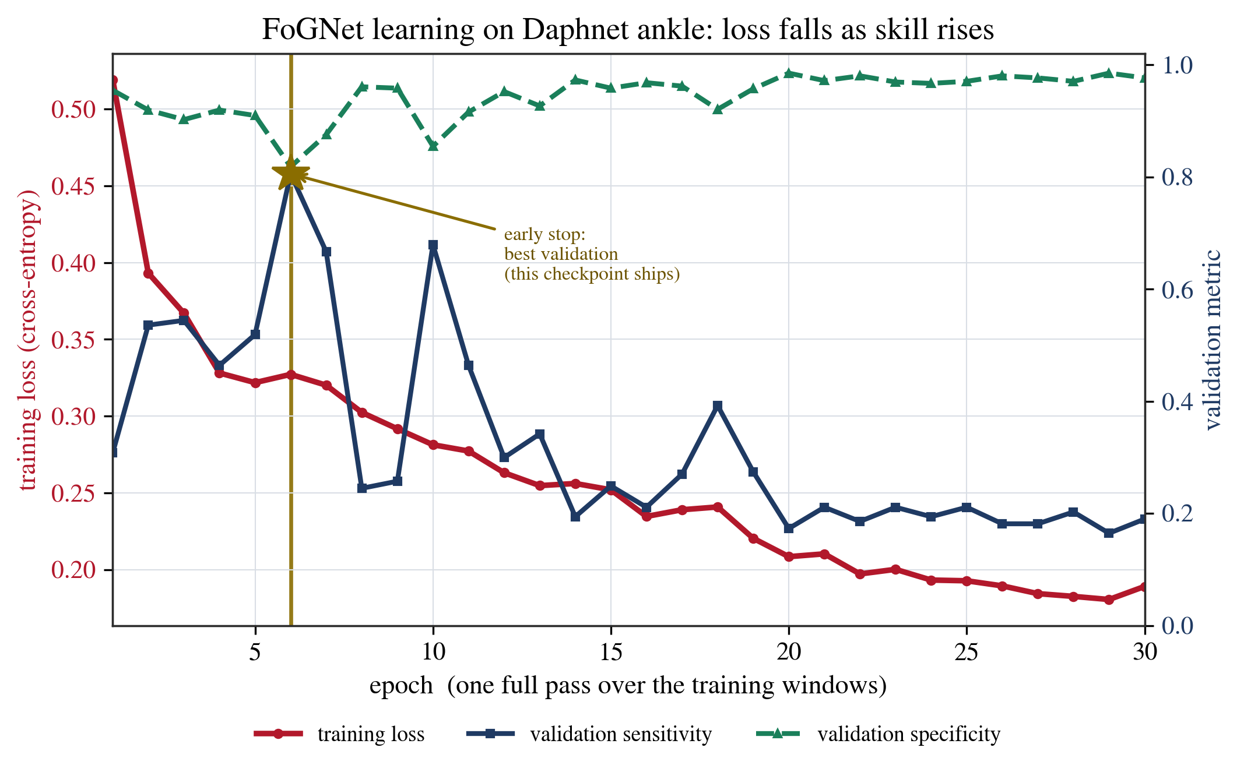
pi/accuracy_figs/train_curve.png
