Pai-88/cadence-fog-monitor/worksheet/zoom-bce.png

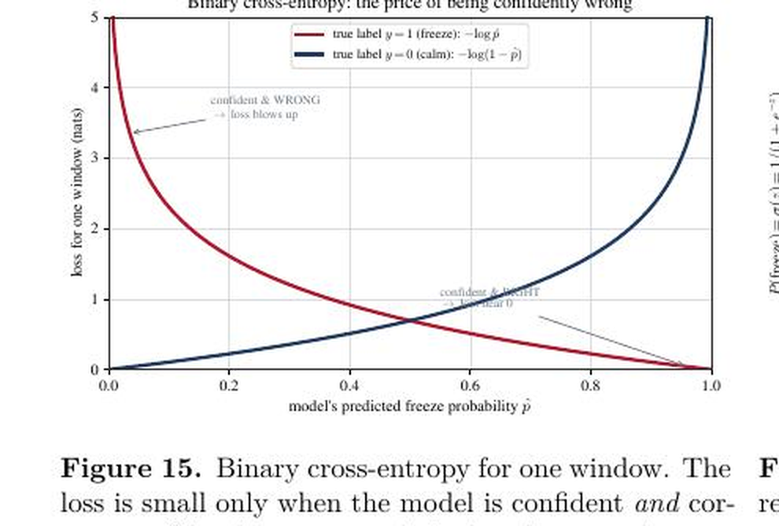
worksheet/zoom-bce.png
