Pai-88/cadence-fog-monitor/deliverables/cadence_print_pack.pdf

U C L E N G F 0 0 3 1 · S M A R T C L O T H I N G P R O T O T Y P E

# Cadence

## A wearable that senses a Parkinson's gait freeze and gently cues the

next step — automatically, on the body.

ONE SENSOR. THREE JOBS.

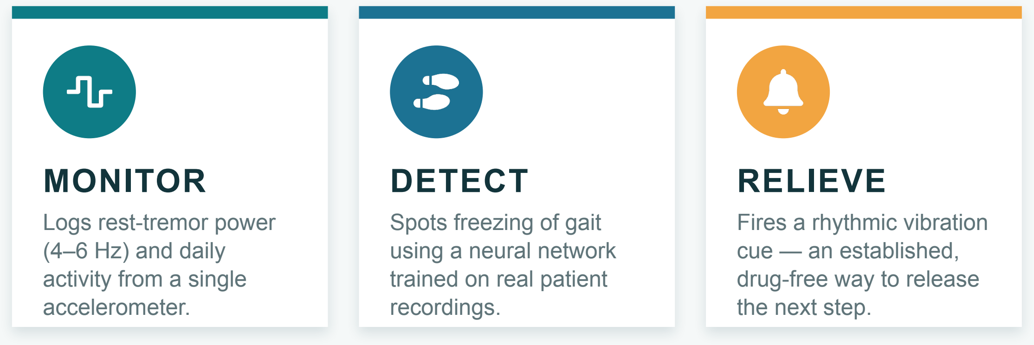
[picture p106: figure]
MONITOR; Logs rest-tremor power (4–6 Hz) and daily activity from a single accelerometer.; DETECT; Spots freezing of gait using a neural network trained on real patient recordings.; RELIEVE; Fires a rhythmic vibration cue — an established, drug-free way to release the next step.

### HOW IT WORKS — A TRUE CLOSED LOOP

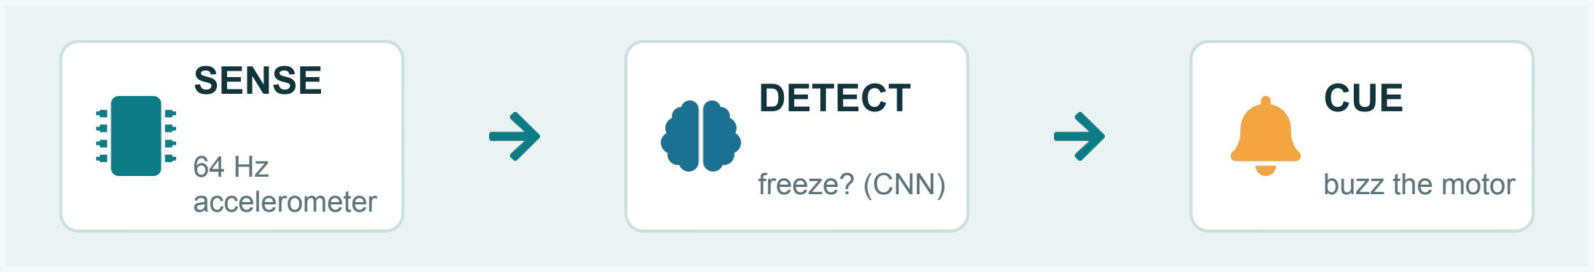
[picture p107: figure]
SENSE; 64 Hz accelerometer; DETECT; freeze? (CNN); CUE; buzz the motor

The cue fires as soon as a freeze is detected, then the garment keeps watching — one sensor in, one cue out.

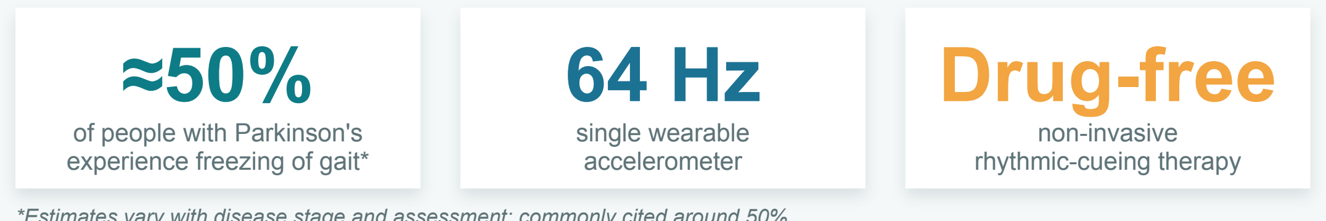
[picture p108: figure]
of people with Parkinson's experience freezing of gait*; single wearable accelerometer; Drug-free; non-invasive rhythmic-cueing therapy

*Estimates vary with disease stage and assessment; commonly cited around 50%.

In good company. Builds on ideas demonstrated by Apple Watch's Movement Disorder API, PDMonitor, STAT-ON and NextStride cueing aids — combined into one low-cost garment.

Validated on real patient recordings (Daphnet) using leave-one-subject-out testing.

Cadence — closed-loop gait garment | Research prototype — not a medical device UCL ENGF0031 Scenario 2 · 2026

R E A L P A T I E N T D A T A · L E A V E - O N E - S U B J E C T - O U T

# Does the freeze detector work?

FoGNet 1-D CNN · Daphnet (10 Parkinson's patients) · ankle accelerometer

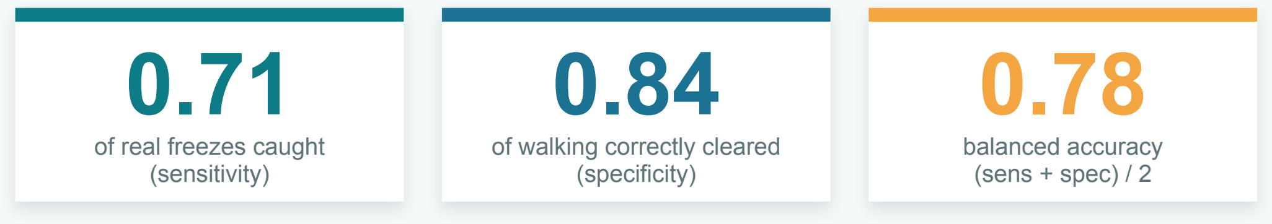
[picture p109: figure]
of real freezes caught (sensitivity); of walking correctly cleared (specificity); balanced accuracy (sens + spec) / 2

CONFUSION MATRIX · n=8982

true ↓ pred → | no-freeze | freeze
no-freeze | 6842 correct walk | 1285 false alarm
freeze | 248 MISSED freeze | 607 caught freeze

VERSUS BASELINES

Approach | Sens | Spec
FoGNet (CNN) | 0.71 | 0.84
Freeze-Index | 0.002 | 0.994
Always 'no-freeze' | 0.00 | 1.00

Each held-out patient is scored once, then pooled — no patient is in both train and test.

Why not “accuracy”? A model that NEVER calls a freeze scores 90.5% accuracy — yet catches zero freezes and prevents zero falls. A missed freeze can mean a fall, so sensitivity & specificity are the honest metrics here, not accuracy.

DATASET & METHOD

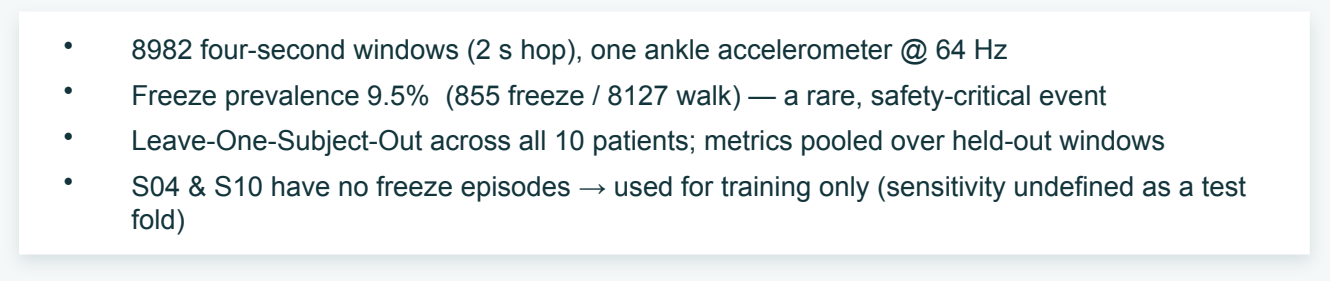
[picture p110: figure]
fold)

- 8982 four-second windows (2 s hop), one ankle accelerometer @ 64 Hz
- Freeze prevalence 9.5% (855 freeze / 8127 walk) — a rare, safety-critical event
- Leave-One-Subject-Out across all 10 patients; metrics pooled over held-out windows
- S04 & S10 have no freeze episodes → used for training only (sensitivity undefined as a test

Per-patient sensitivity spans 0.45–0.98 (wide between-subject variability is expected for real Parkinson's gait; the pooled 0.71 is the headline).

Cadence — closed-loop gait garment | Results · page 1 of 2

# Which signals flag a freeze?

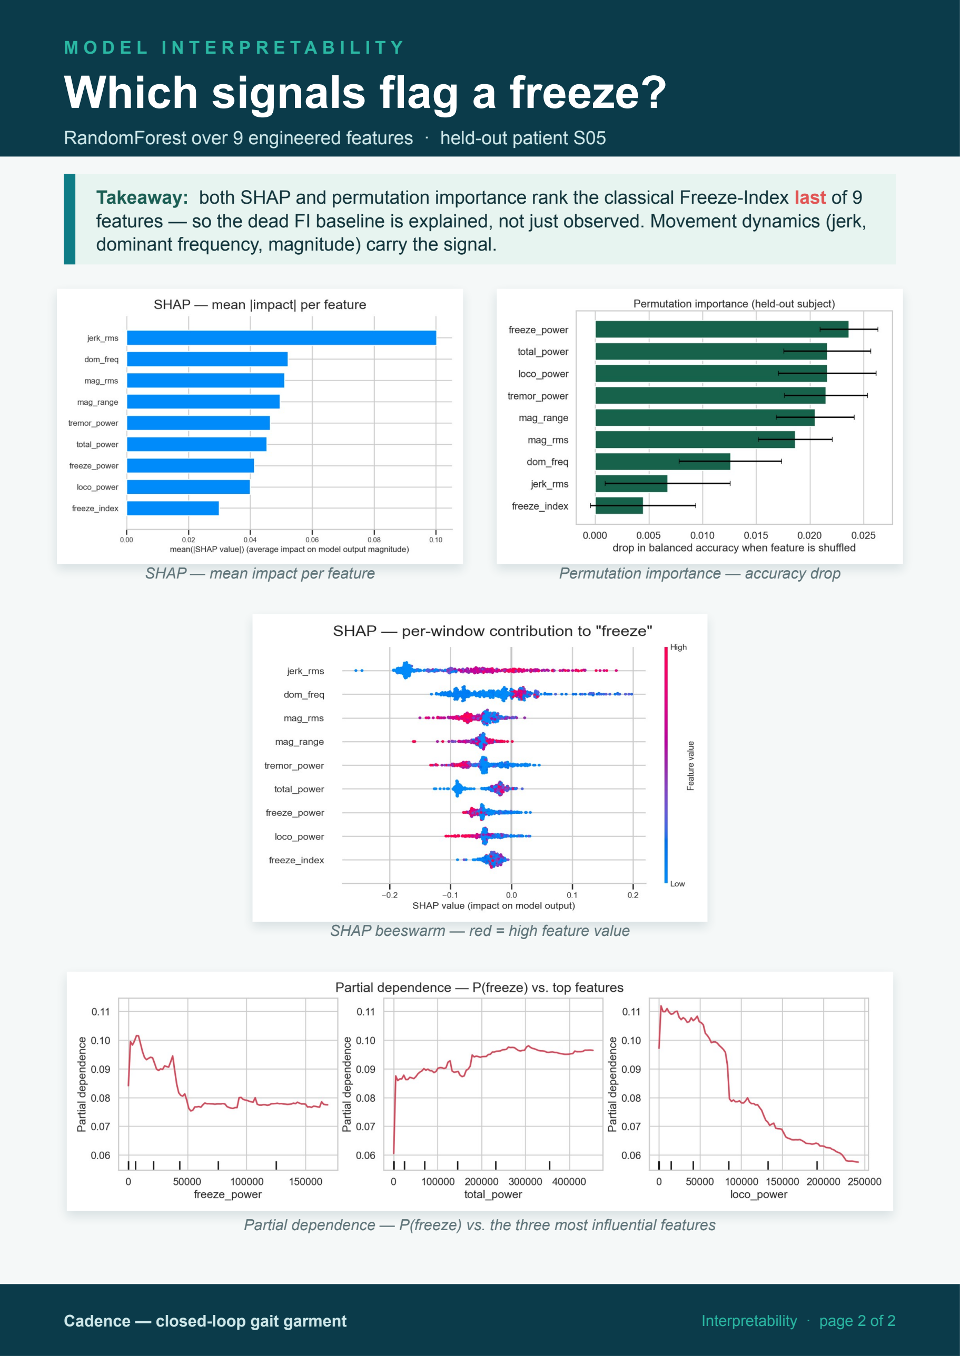
[picture p111: page 3]

M O D E L I N T E R P R E T A B I L I T Y

RandomForest over 9 engineered features · held-out patient S05

Takeaway: both SHAP and permutation importance rank the classical Freeze-Index last of 9 features — so the dead FI baseline is explained, not just observed. Movement dynamics (jerk, dominant frequency, magnitude) carry the signal.

SHAP — mean impact per feature | Permutation importance — accuracy drop

SHAP beeswarm — red = high feature value

Partial dependence — P(freeze) vs. the three most influential features

Cadence — closed-loop gait garment | Interpretability · page 2 of 2
