Pai-88/cadence-fog-monitor/pi/accuracy_figs/operating_point.png

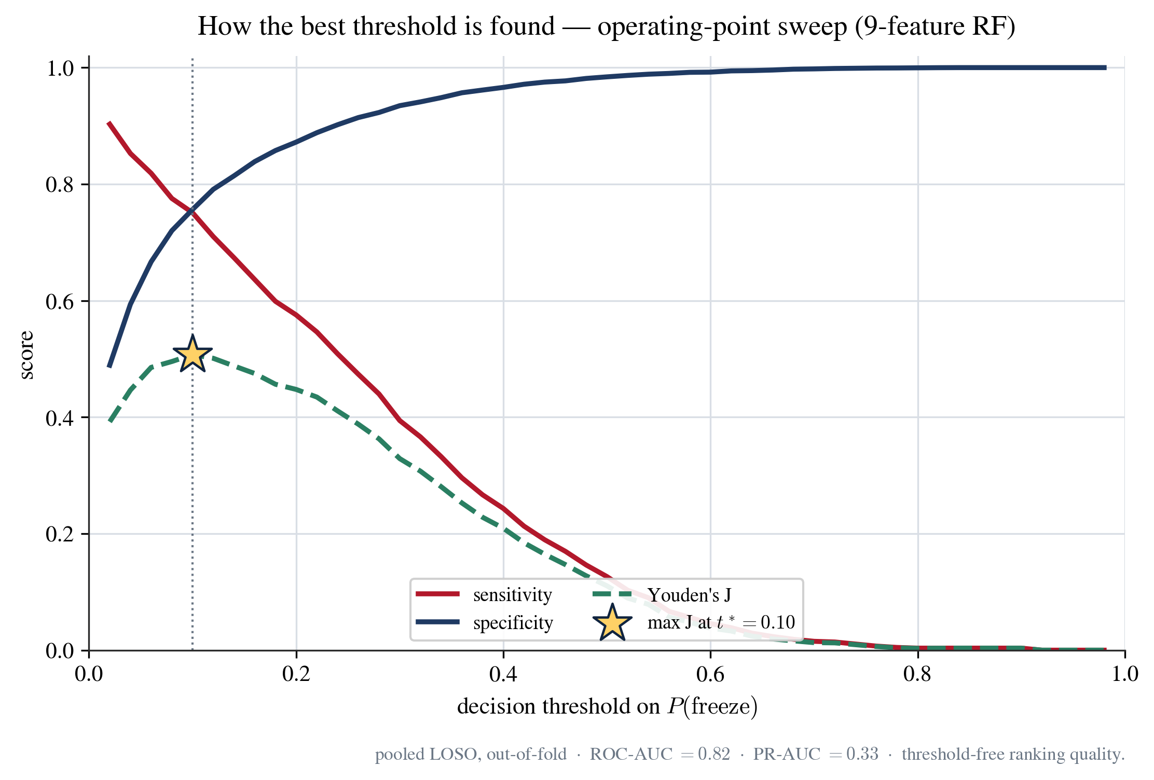
pi/accuracy_figs/operating_point.png
