Pai-88/cadence-fog-monitor/pi/accuracy_figs/calibration.pdf

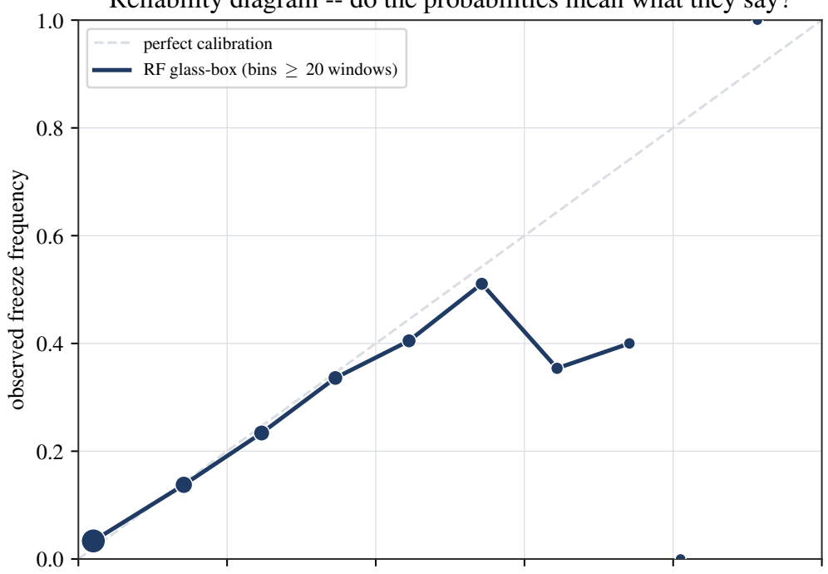
[picture p113: figure]
observed freeze frequency; perfect calibration RF glass-box (bins ¸ 20 windows)

Reliability diagram -- do the probabilities mean what they say?

0.0 | 0.2 | 0.4 | 0.6 | 0.8 | 1.0
predicted freeze probability p^

10

1

10

2

10

3
windows

(log)
