Pai-88/cadence-fog-monitor/pi/accuracy_figs/results_sheet.pdf

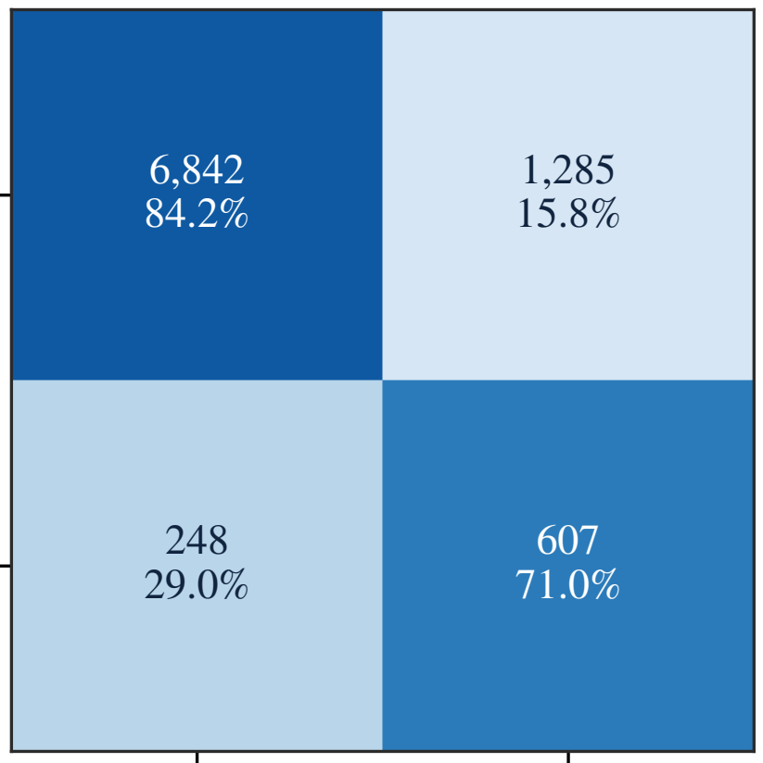
[picture p114: figure]

no-freeze | freeze

### predicted

### no-freeze

### freeze

true

## (a) CNN — confusion matrix

0.0 | 0.2 | 0.4 | 0.6 | 0.8 | 1.0

Accuracy

MCC

Balanced acc.

F1 score

NPV

Precision (PPV)

Specificity

Sensitivity (recall)

0.83

0.40

0.78

0.44

0.97

0.32

0.84

0.71

## (b) CNN — operating-point metrics

0.00 | 0.01 | 0.02 | 0.03 | 0.04 | 0.05 | 0.06 | 0.07 | 0.08

freeze_index

dom_freq

tremor_power

loco_power

mag_rms

mag_range

freeze_power

jerk_rms

total_power

## (c) 9-feature RF — permutation importance

0.00 | 0.02 | 0.04 | 0.06 | 0.08 | 0.10
| | | mean jSHAPj

freeze_index

loco_power

freeze_power

mag_rms

total_power

tremor_power

mag_range

dom_freq

jerk_rms

## (d) 9-feature RF — SHAP mean impact

## Freezing-of-gait detection — results summary (pooled LOSO)

Top row: the deployed CNN detector. Bottom row: a simpler 9-feature RandomForest, shown for interpretability. Detection sensitivity / specificity — CNN: 0.71 / 0.84 vs 9-feature RF: 0.12 / 0.98
