Pai-88/cadence-fog-monitor/pi/accuracy_figs/calibration.png

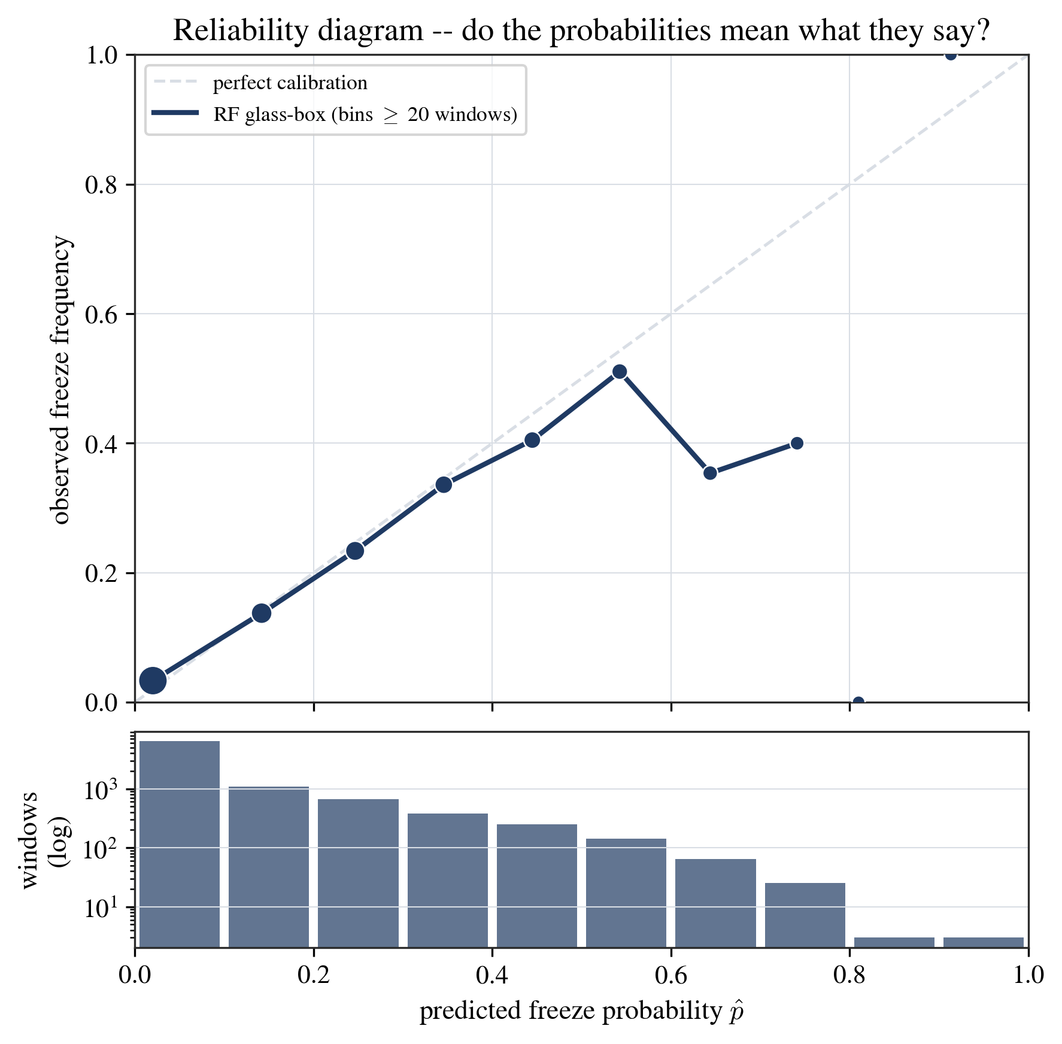
pi/accuracy_figs/calibration.png
