Pai-88/cadence-fog-monitor/pi/accuracy_figs/results_sheet.png

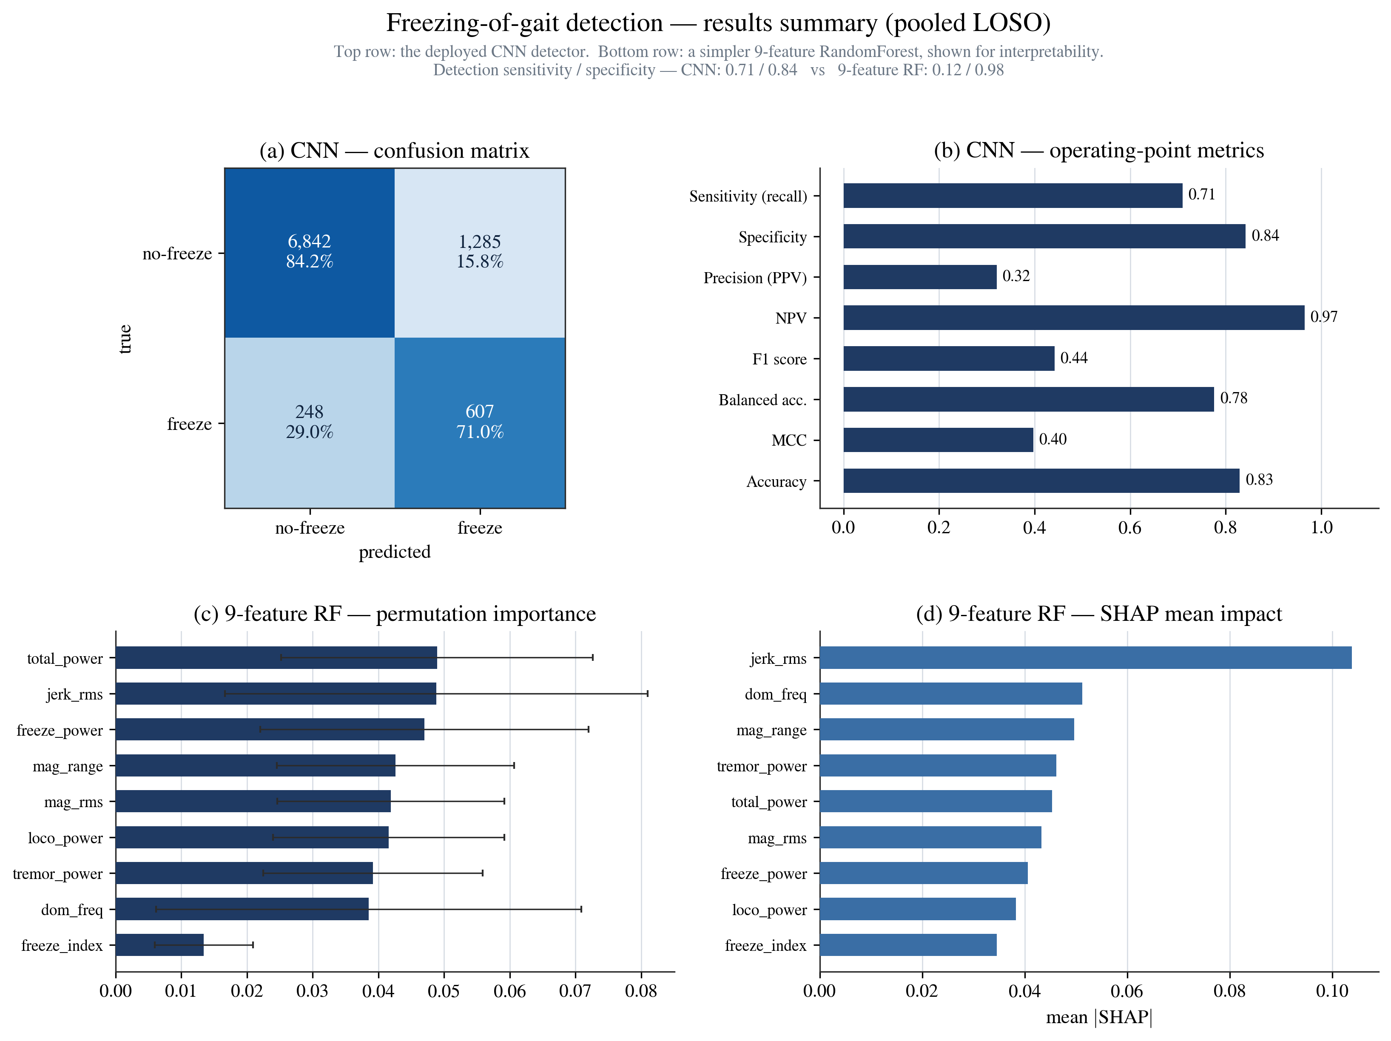
pi/accuracy_figs/results_sheet.png
