Pai-88/cadence-fog-monitor/worksheet/qa_bce_loss-1.png

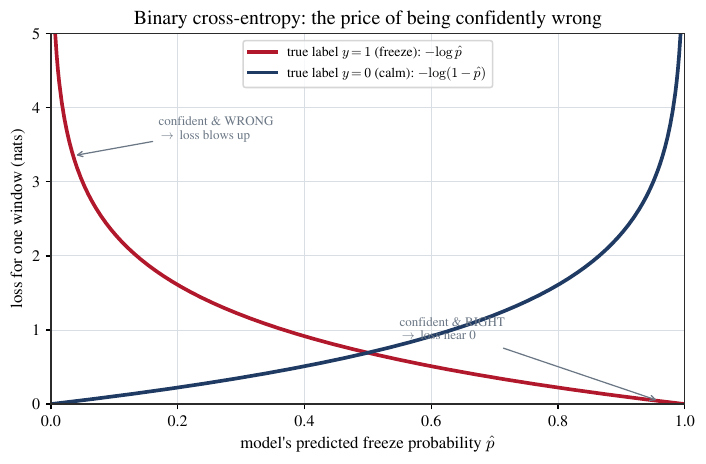
worksheet/qa_bce_loss-1.png
