Pai-88/cadence-fog-monitor/worksheet/qa_calibration-1.png

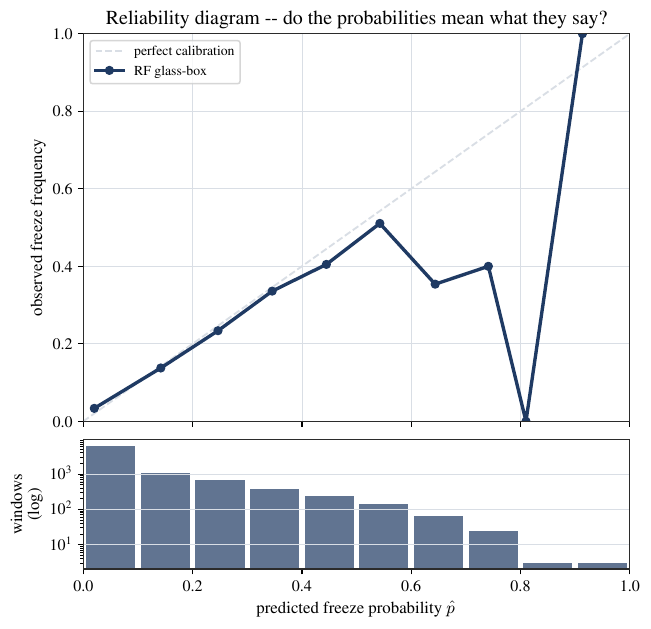
worksheet/qa_calibration-1.png
