Pai-88/cadence-fog-monitor/worksheet/qa_feature_dist-1.png

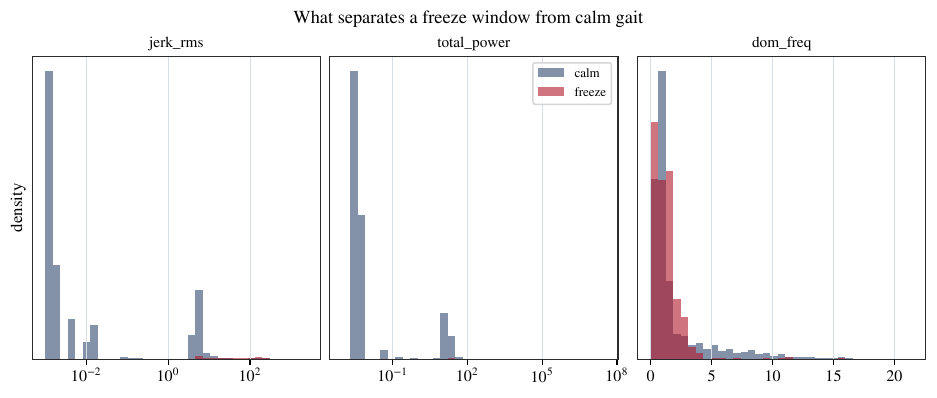
worksheet/qa_feature_dist-1.png
