Pai-88/cadence-fog-monitor/worksheet/qa_per_subject-1.png

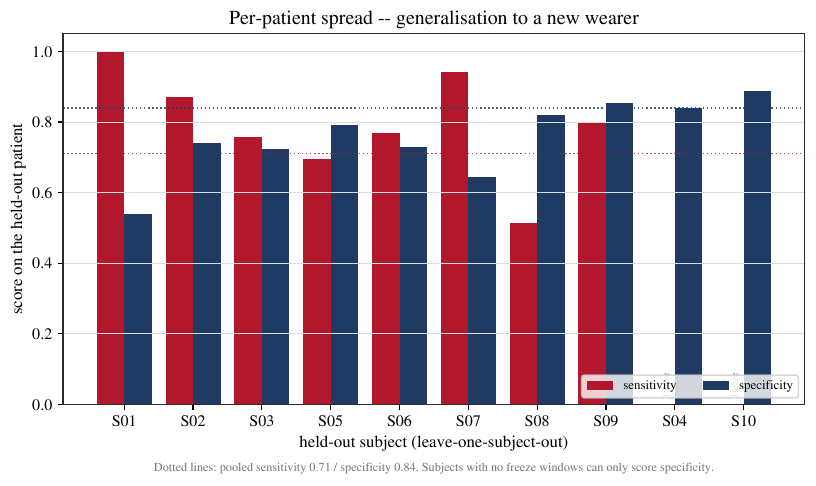
worksheet/qa_per_subject-1.png
