Pai-88/cadence-fog-monitor/worksheet/qa_sigmoid-1.png

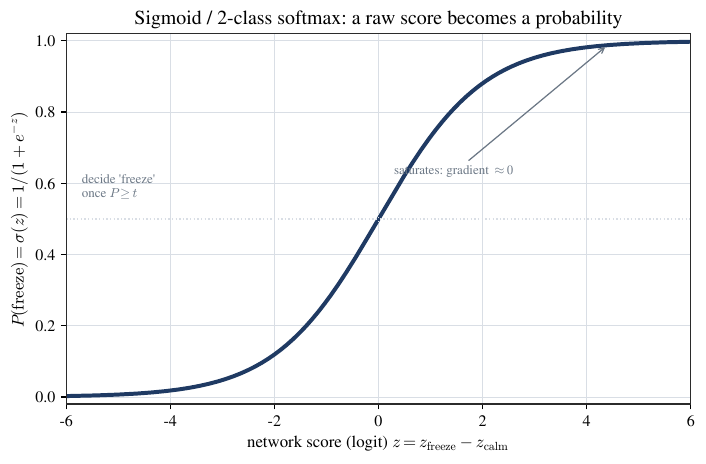
worksheet/qa_sigmoid-1.png
