Pai-88/cadence-fog-monitor/worksheet/qa_train_curve-1.png

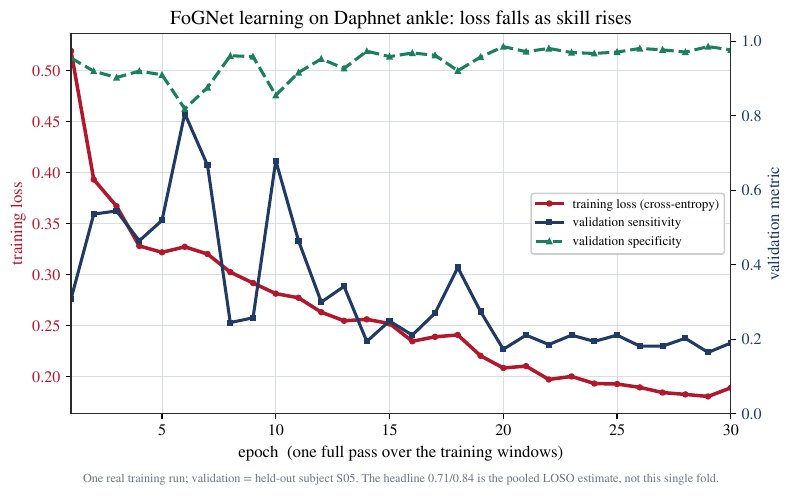
worksheet/qa_train_curve-1.png
