Pai-88/cadence-fog-monitor/hardware/coding_flowchart.pdf

## Coding flowchart standalone on-board firmware

## loop()

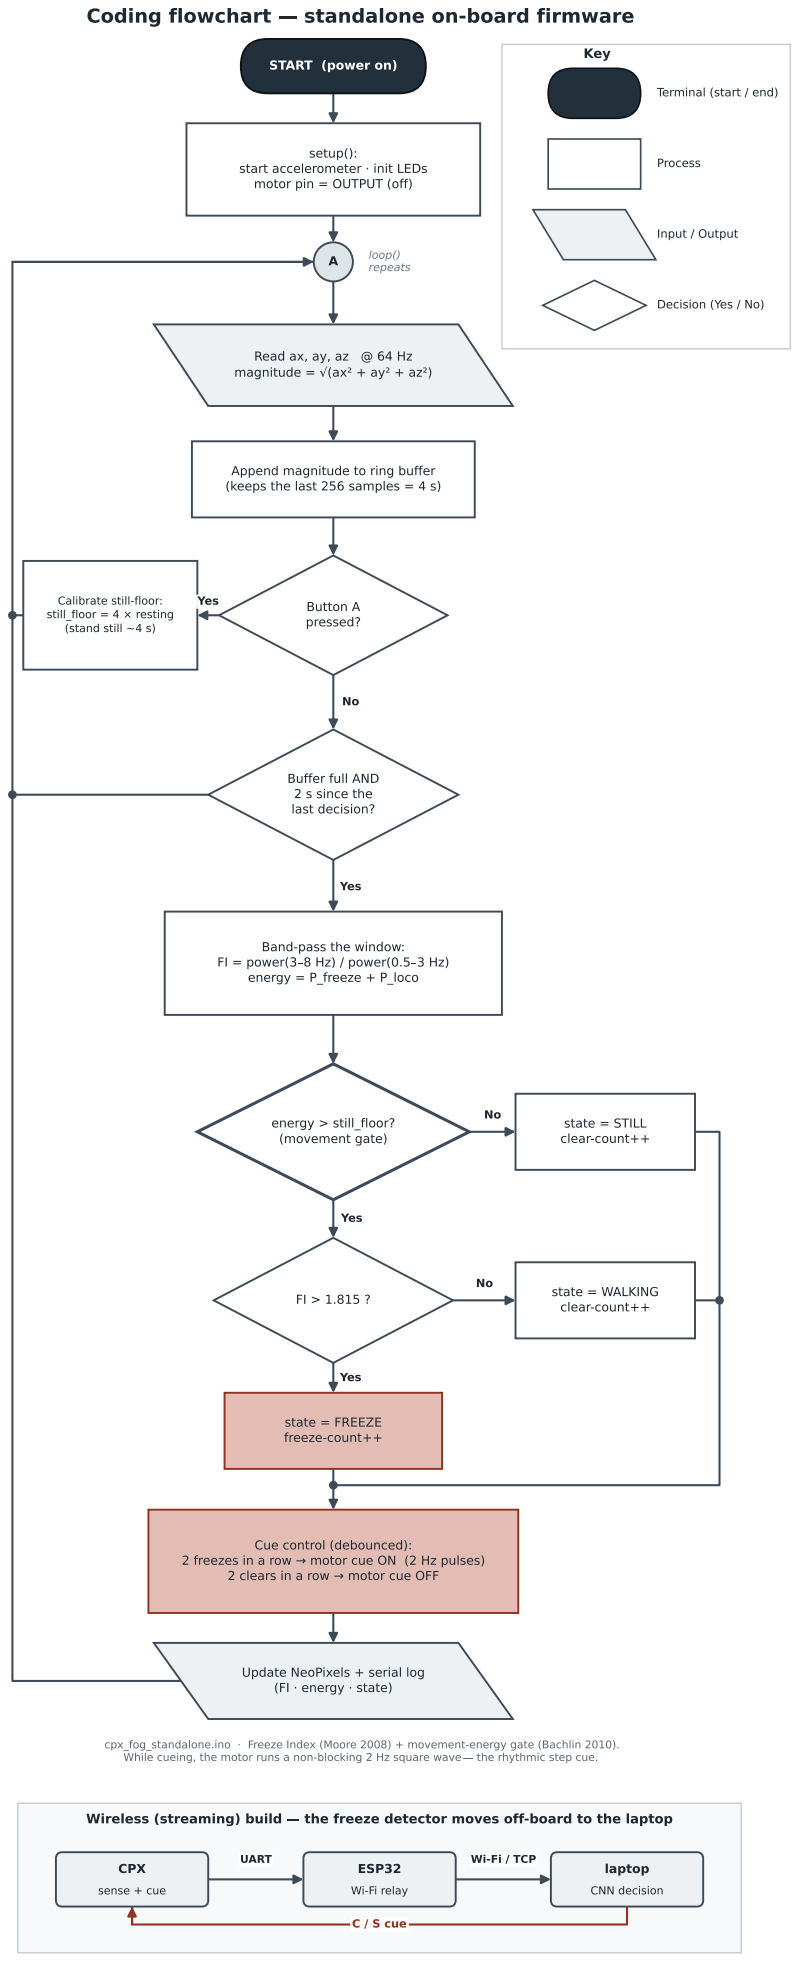
[picture p123: page 1]
repeats; While cueing, the motor runs a non-blocking 2 Hz square wave; the rhythmic step cue.; setup():; Button A pressed?; since the; last; decision?; FI = power(3 8; Hz) / power(0.5 3 Hz); energy = P_freeze + P_loco; energy; > still_floor?; (movement gate); state =; FREEZE; freeze-count++; 2 freezes in a row; motor cue ON (2 Hz pulses); 2 clears in a row; motor cue OFF; state = STILL clear-count++; state = WALKING clear-count++; Key; Process; Input / Output; Wireless (streaming) build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

START (power on)

Terminal (start / end)

start accelerometer · init LEDs
motor pin = OUTPUT (off)

Decision (Yes / No)

Read ax, ay, az @ 64 Hz
magnitude = (ax² + ay² + az²)

Append magnitude to ring buffer
(keeps the last 256 samples = 4 s)

Calibrate still-floor:
still_floor = 4 × resting
(stand still ~4 s)

Buffer full AND

Band-pass the window:

Cue control (debounced):

Update NeoPixels + serial log
(FI · energy · state)

cpx_fog_standalone.ino · Freeze Index (Moore 2008) + movement-energy gate (Bachlin 2010).

Wi-Fi relay
