Pai-88/cadence-fog-monitor/pi/accuracy_figs/decision_contour.pdf

## How a window is categorised — P(freeze) over two features

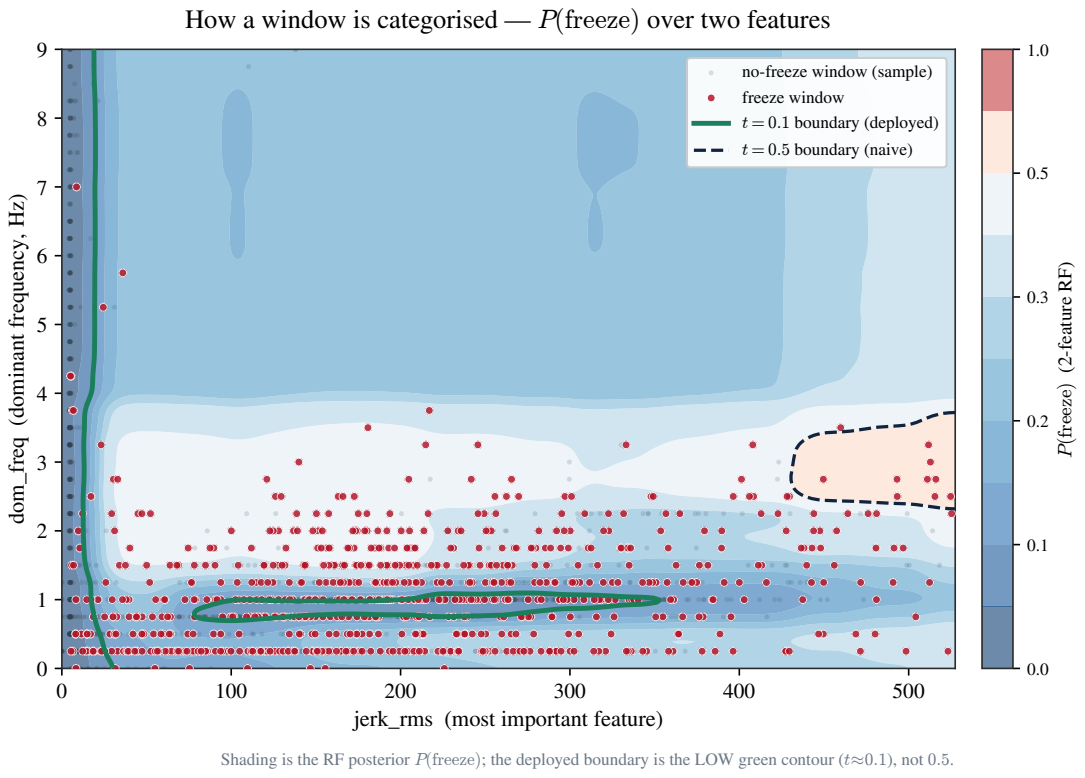
[picture p124: page 1]
P(freeze) (2-feature R

no-freeze window (sample)
freeze window
t = 0:1 boundary (deployed)
t = 0:5 boundary (naive)

dom_freq (dominant frequency, Hz)

jerk_rms (most important feature)

Shading is the RF posterior P(freeze); the deployed boundary is the LOW green contour (t¼0:1), not 0:5.
