Pai-88/cadence-fog-monitor/pi/accuracy_figs/gradient_descent.pdf

2

3

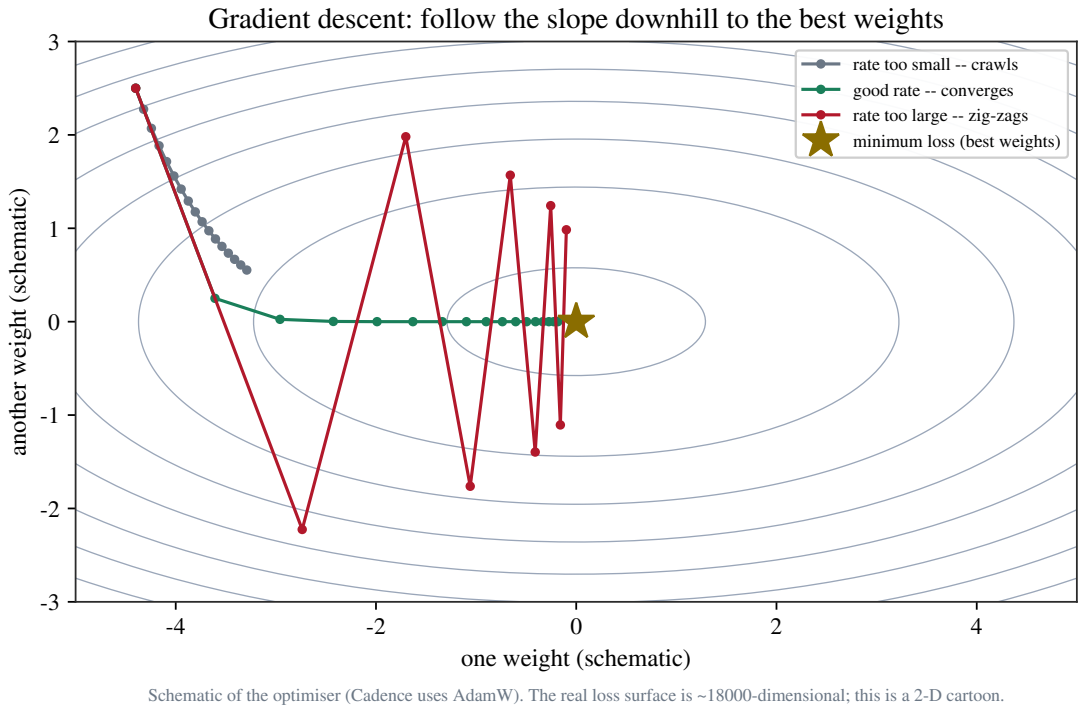
[picture p125: page 1]

Gradient descent: follow the slope downhill to the best weights

rate too small -- crawls
good rate -- converges
rate too large -- zig-zags
minimum loss (best weights)

another weight (schematic)

one weight (schematic)

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
