Pai-88/cadence-fog-monitor/pi/accuracy_figs/smoketest_trace.pdf

1500

2000

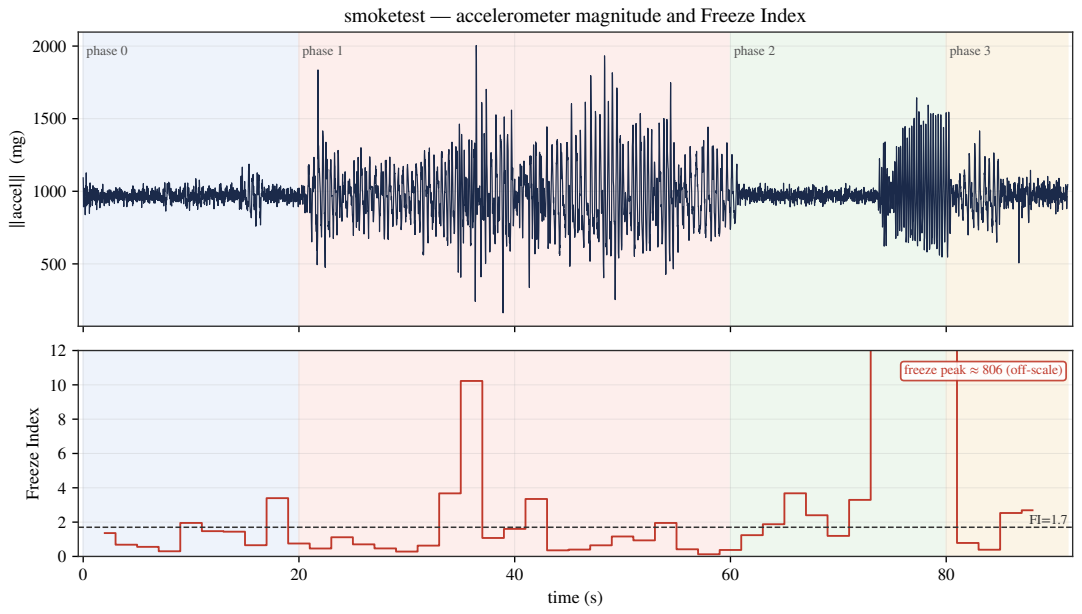
[picture p126: page 1]
‖accel‖ (mg); phase 0; phase 1; phase 2; phase 3; time (s); Freeze Index

smoketest — accelerometer magnitude and Freeze Index

freeze peak ≈ 806 (off-scale)
