Pai-88/cadence-fog-monitor/pi/accuracy_figs/operating_point.pdf

## How the best threshold is found — operating-point sweep (9-feature RF)

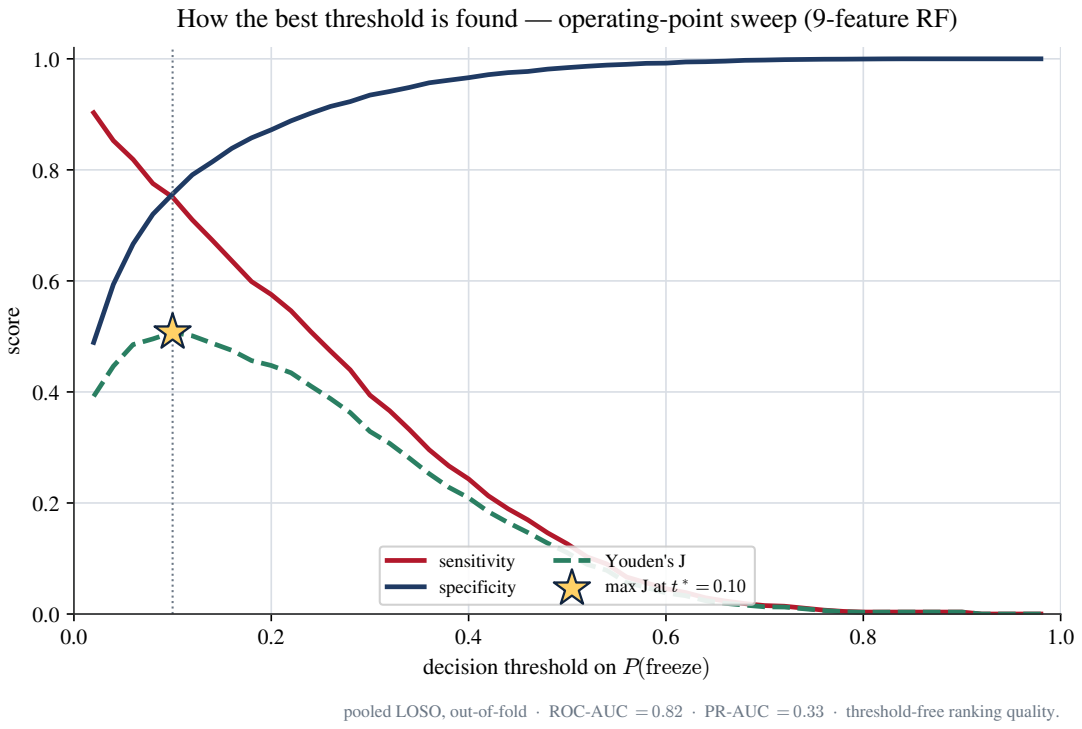
[picture p127: page 1]
score; sensitivity specificity; Youden's J max J at t

decision threshold on P(freeze)

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
