Pai-88/cadence-fog-monitor/pi/accuracy_figs/param_grid.pdf

## How the best parameters are found — grid search over model complexity

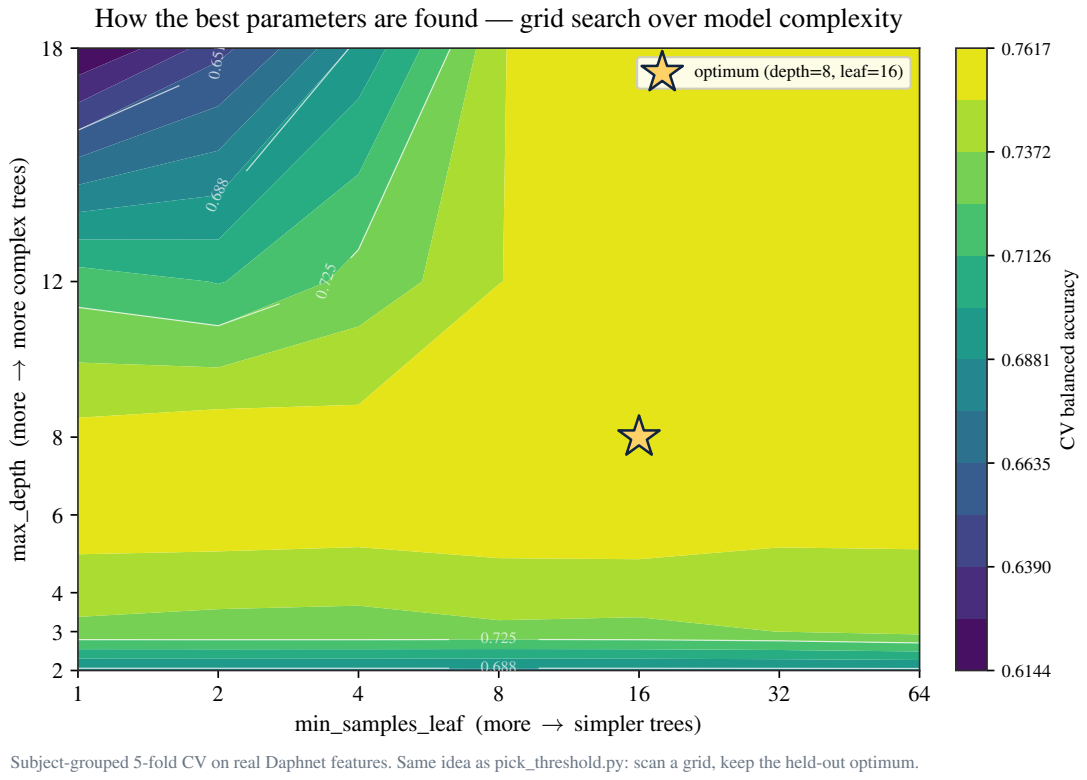
[picture p128: page 1]
max; depth (m; ore !; ore co; plex trees)

optimum (depth=8, leaf=16)

CV balanced accuracy

min_samples_leaf (more ! simpler trees)

Subject-grouped 5-fold CV on real Daphnet features. Same idea as pick_threshold.py: scan a grid, keep the held-out optimum.
