Pai-88/cadence-fog-monitor/pi/accuracy_figs/pr_curve.pdf

## Precision-recall -- the honest view under 9.5% prevalence

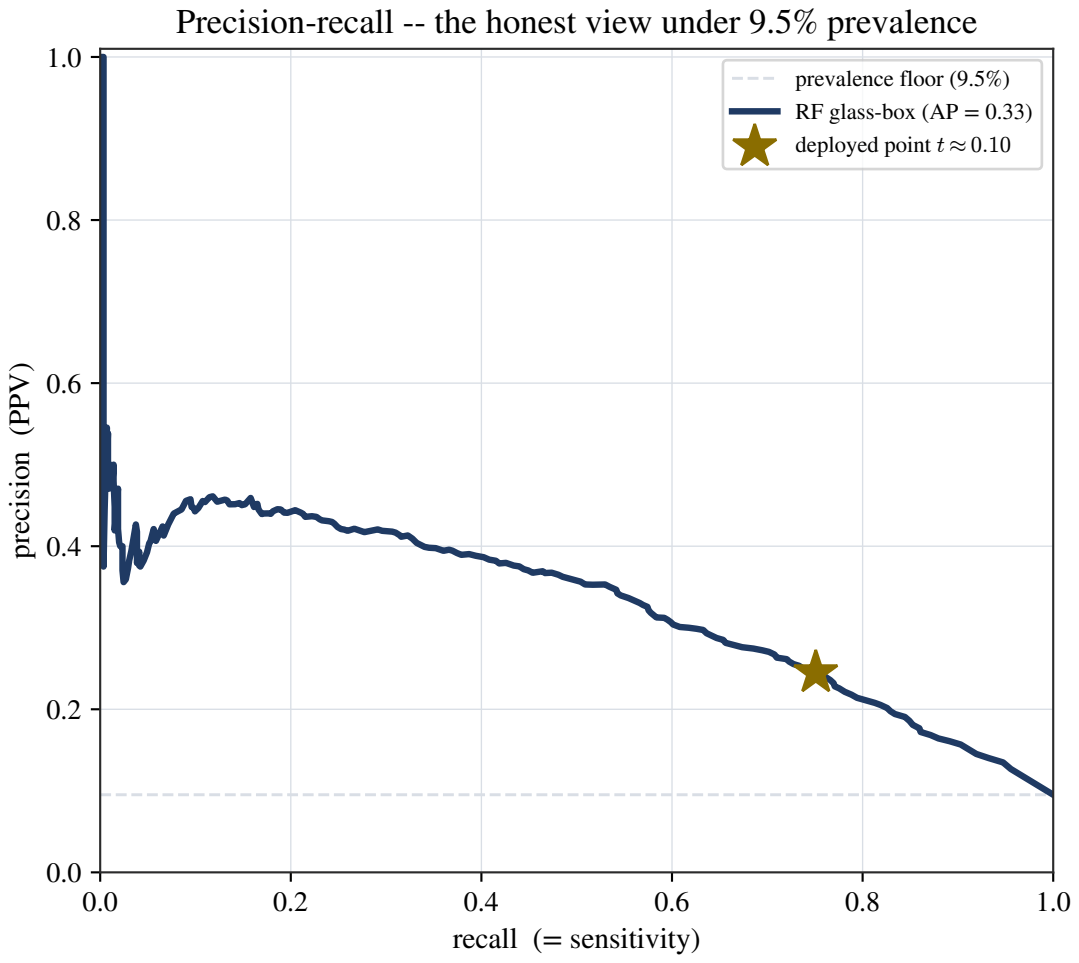
[picture p129: page 1]
recall (= sensitivity); precision (PPV)

prevalence floor (9.5%)
RF glass-box (AP = 0.33)
deployed point t ¼ 0:10
