Pai-88/cadence-fog-monitor/pi/accuracy_figs/roc_curve.pdf

## ROC -- sensitivity vs false alarms across every threshold

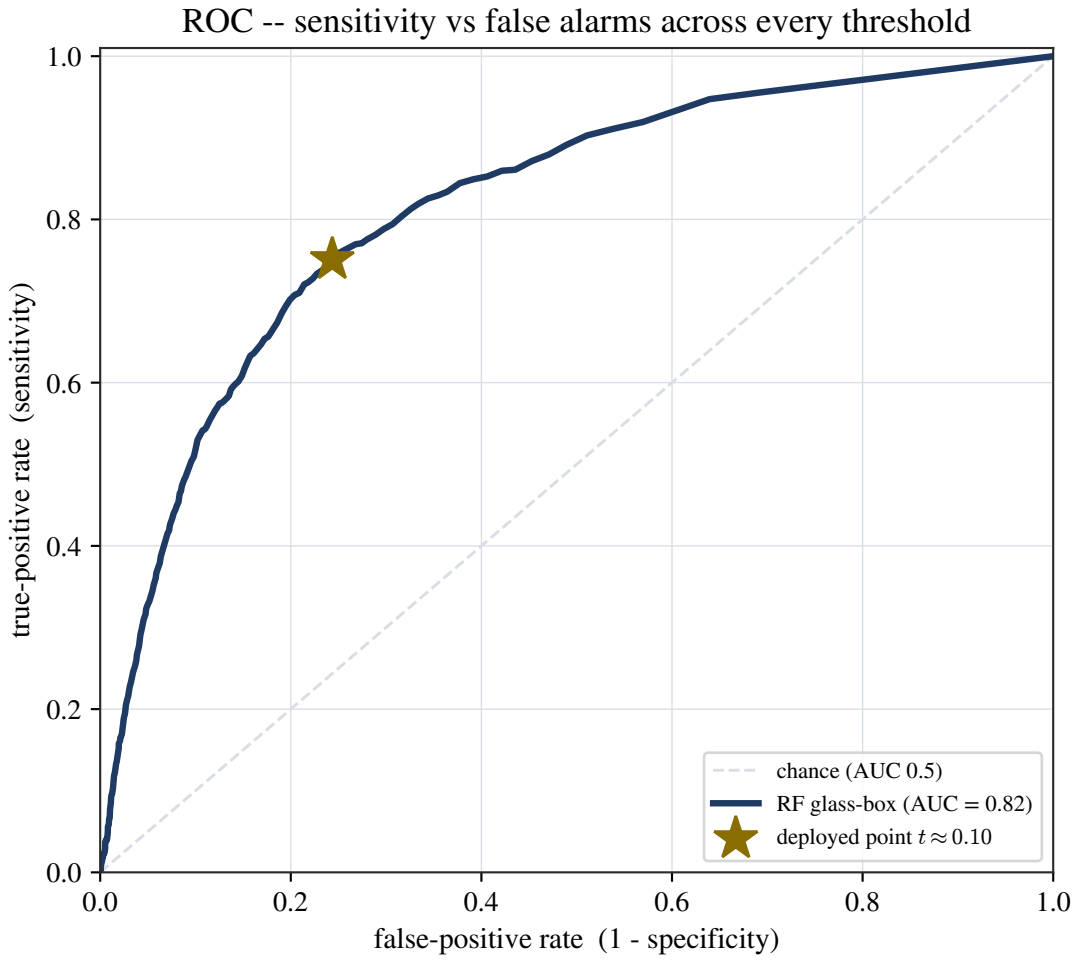
[picture p130: page 1]

true-positive rate (sensitivity)

chance (AUC 0.5)
RF glass-box (AUC = 0.82)
deployed point t ¼ 0:10

false-positive rate (1 - specificity)
