Pai-88/cadence-fog-monitor/pi/accuracy_figs/shap_beeswarm.pdf

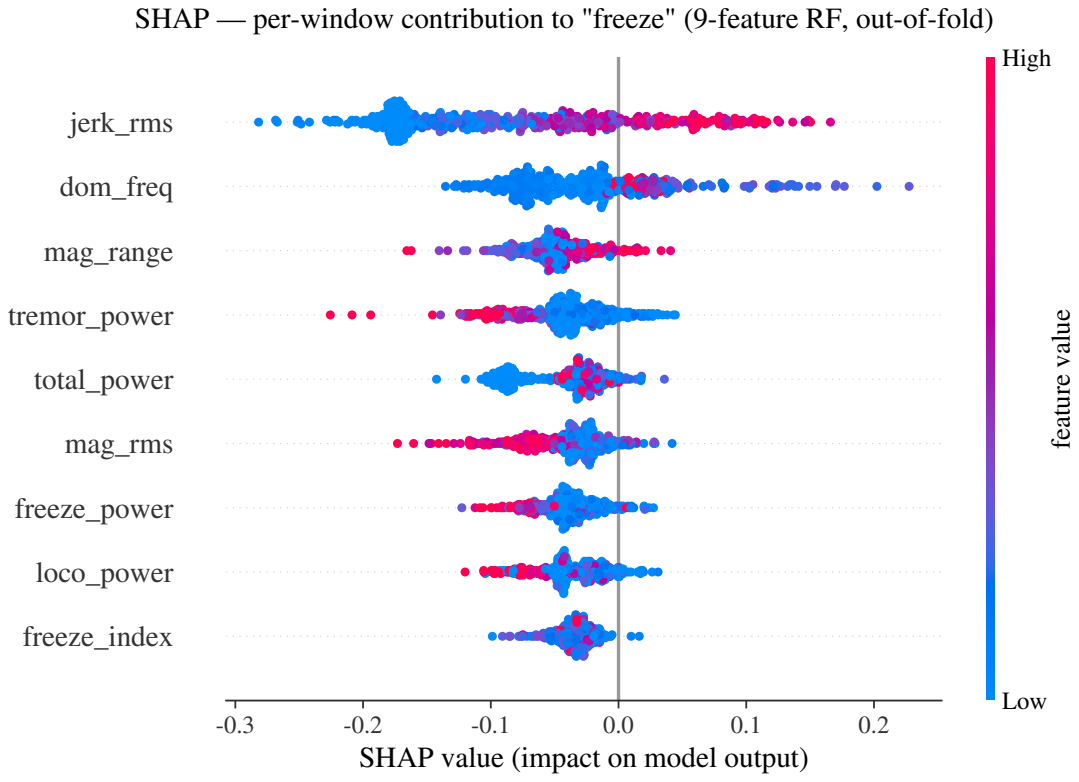
[picture p131: page 1]
freeze_index; loco_power; freeze_power; mag_rms; total_power; tremor_power; mag_range; dom_freq; jerk_rms; Low; High; feature value

SHAP — per-window contribution to "freeze" (9-feature RF, out-of-fold)

SHAP value (impact on model output)
