Pai-88/cadence-fog-monitor/pi/accuracy_figs/train_curve.pdf

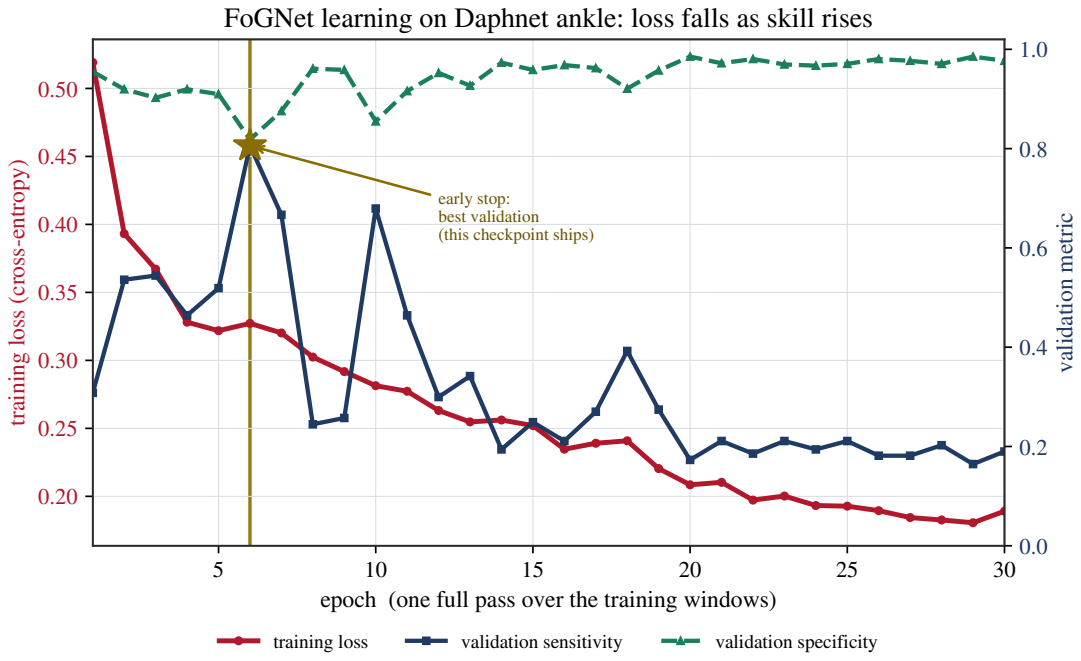
[picture p132: page 1]
validation metric; training loss; validation sensitivity; validation specificity

FoGNet learning on Daphnet ankle: loss falls as skill rises

training loss (cross-entropy)

early stop: best validation
(this checkpoint ships)

epoch (one full pass over the training windows)
